pranjal-joshi/SMART/SMART_CPU/help_ss/betaConf.png

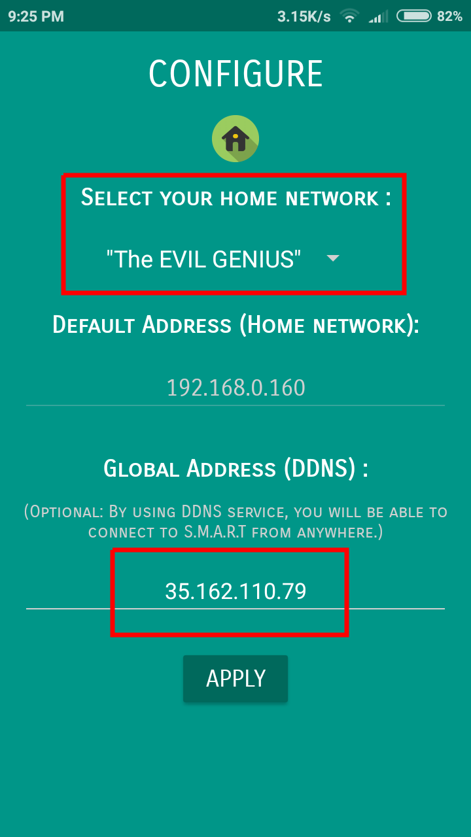
SMART_CPU/help_ss/betaConf.png
