pranjal-joshi/SMART/SMART_CPU/help_ss/config.jpg

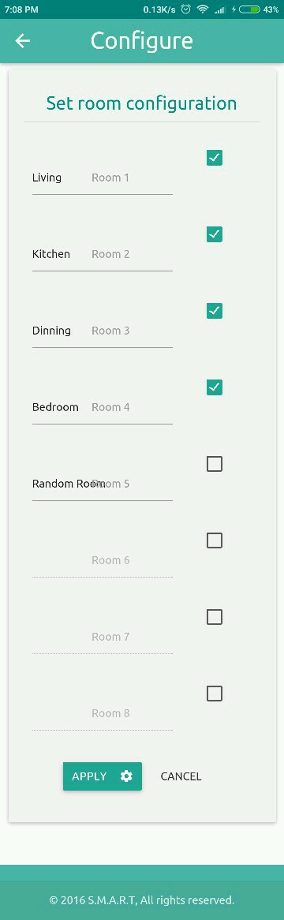
SMART_CPU/help_ss/config.jpg
