pranjal-joshi/SMART/SMART_CPU/help_ss/deviceRename.png

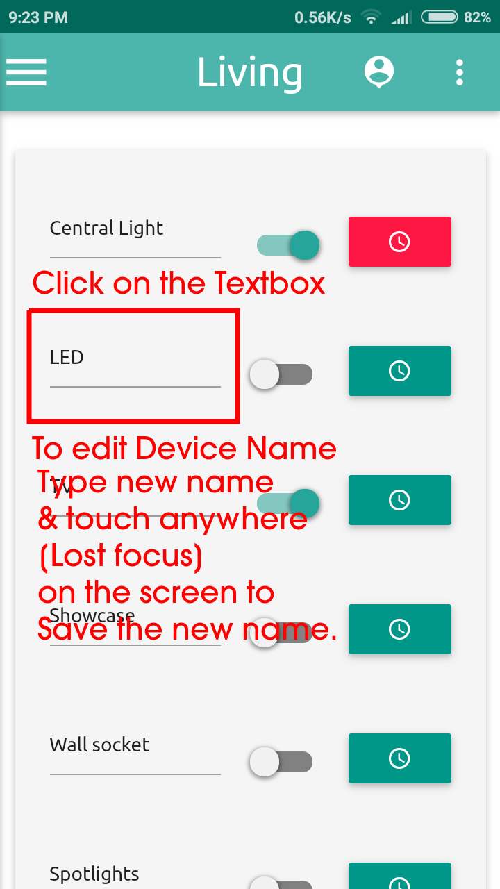
SMART_CPU/help_ss/deviceRename.png
