pranjal-joshi/SMART/SMART_CPU/help_ss/menu.jpg

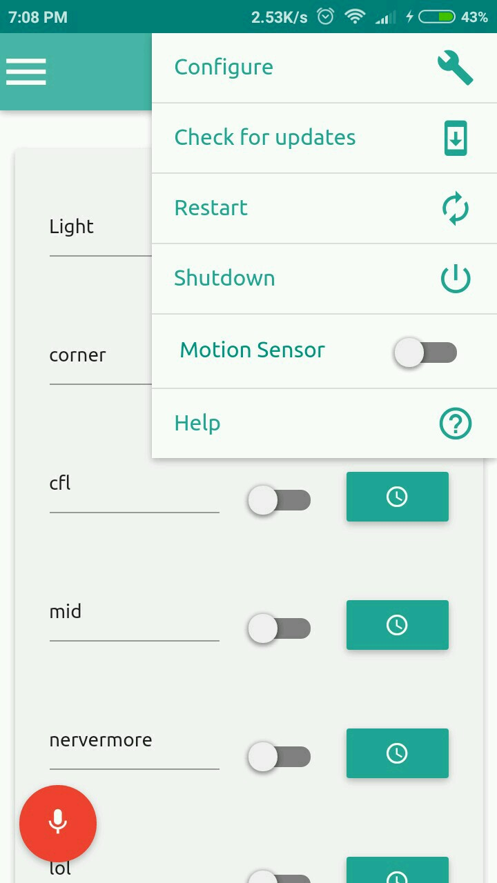
SMART_CPU/help_ss/menu.jpg
