pranjal-joshi/SMART/SMART_CPU/help_ss/profile.jpg

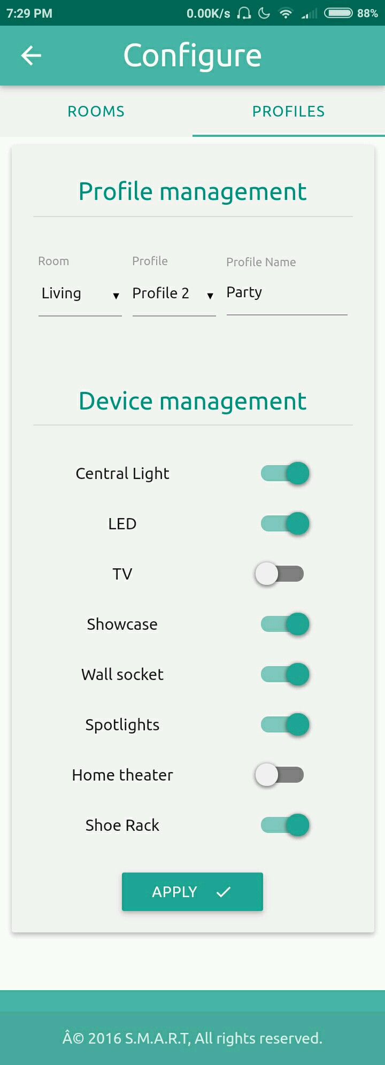
SMART_CPU/help_ss/profile.jpg
