pranjal-joshi/SMART/SMART_CPU/help_ss/Screenshot_2016-10-09-19-06-26-866_smart.webapp.jpg

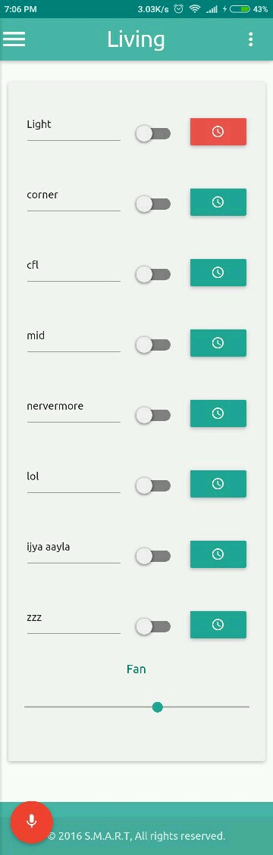
SMART_CPU/help_ss/Screenshot_2016-10-09-19-06-26-866_smart.webapp.jpg
