pranjal-joshi/SMART/SMART_CPU/help_ss/Screenshot_2016-10-09-19-11-12-575_smart.webapp.png

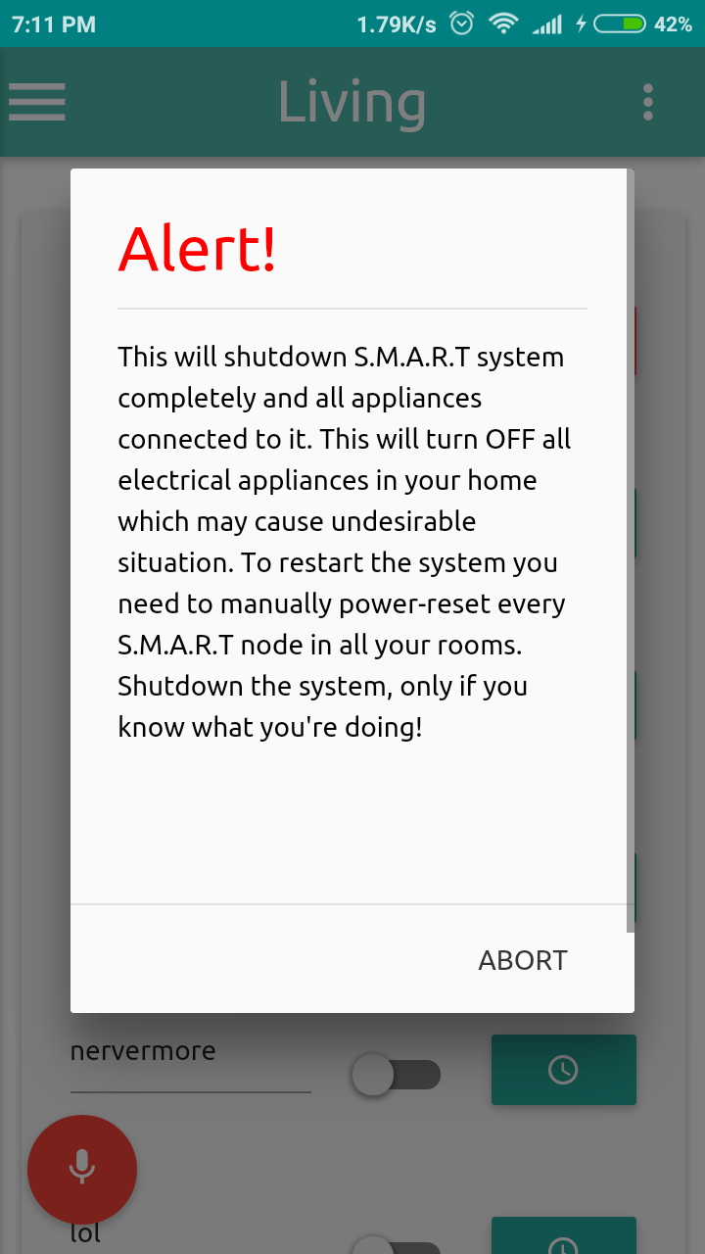
SMART_CPU/help_ss/Screenshot_2016-10-09-19-11-12-575_smart.webapp.png
