pranjal-joshi/SMART/SMART_CPU/help_ss/setProfile.png

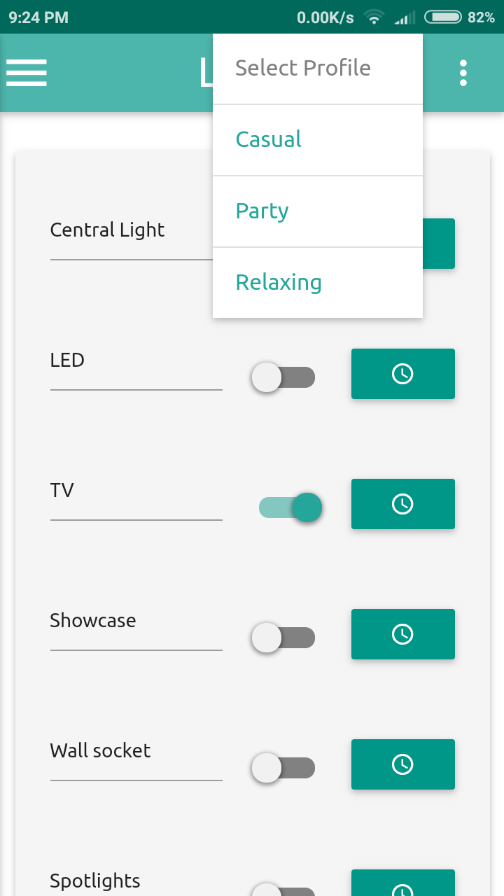
SMART_CPU/help_ss/setProfile.png
