pranjal-joshi/SMART/SMART_CPU/help_ss/timer.jpg

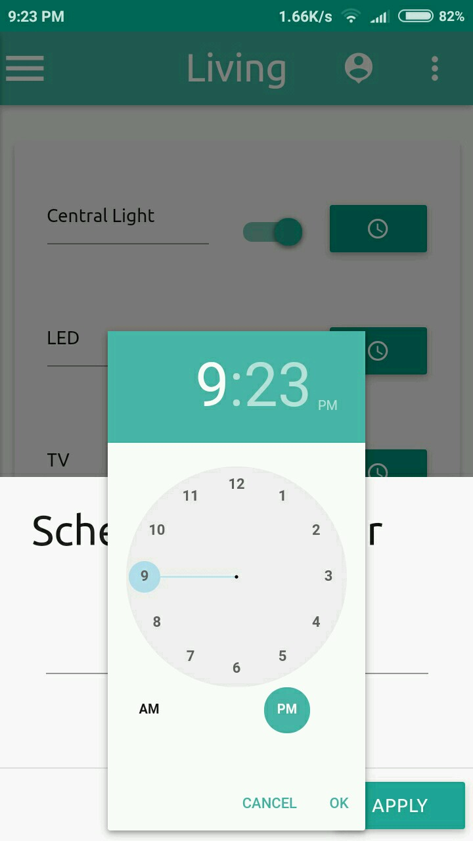
SMART_CPU/help_ss/timer.jpg
