pranjal-joshi/SMART/SMART_CPU/help_ss/update.png

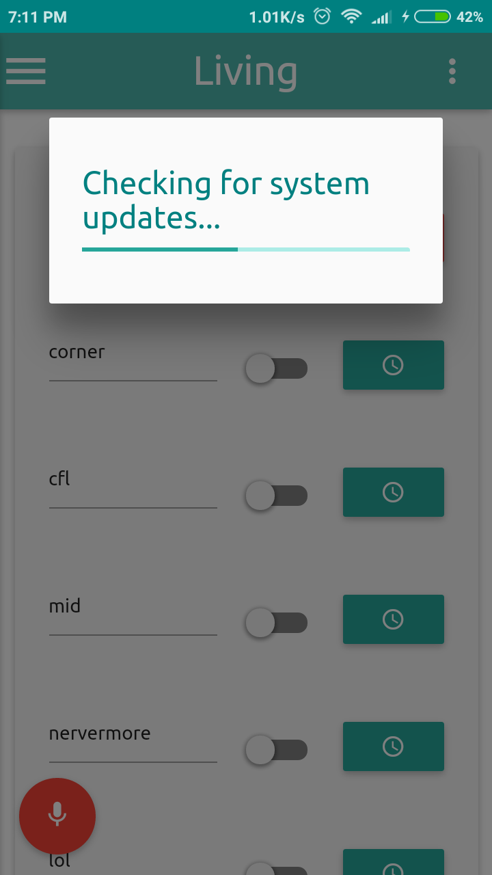
SMART_CPU/help_ss/update.png
