pranjal-joshi/SMART/v4_alexa_based/data/brand-removebg-preview.png

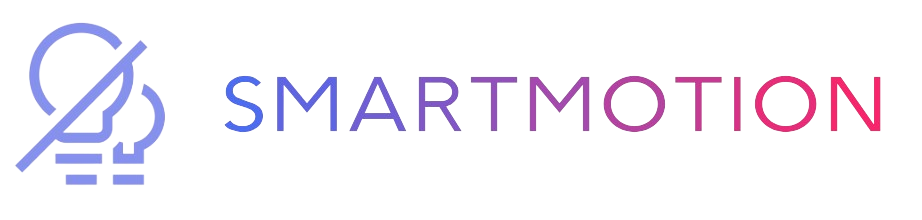
v4_alexa_based/data/brand-removebg-preview.png
