pranjal-joshi/SMART/v4_alexa_based/ESP01 vs ESP01-S.png

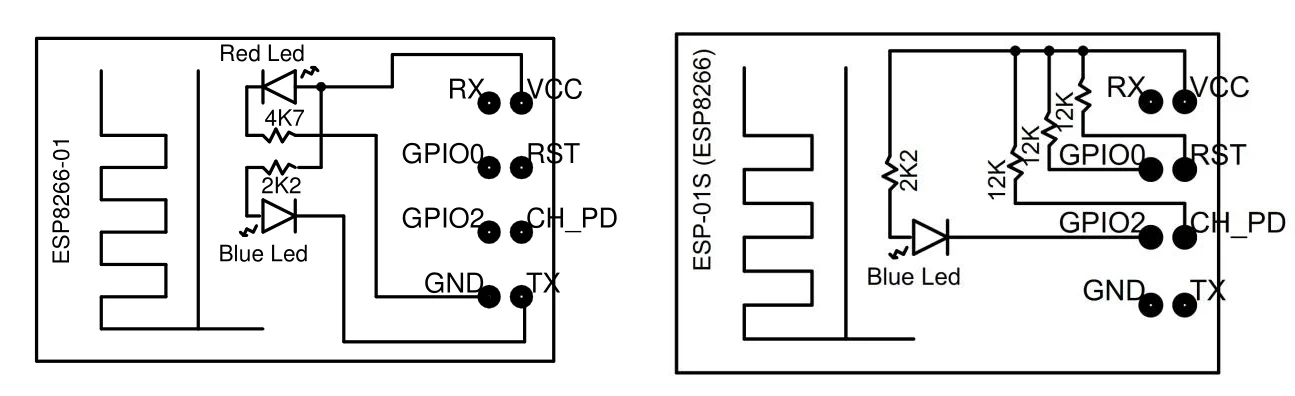
v4_alexa_based/ESP01 vs ESP01-S.png
