pranjal-joshi/SMART/v3/BOM.txt

# 5VDC Relay (230V-10A)
Make: Omron
MPN: G5Q-1-HA DC5
Mouser: https://www.mouser.in/ProductDetail/Omron-Electronics/G5Q-1-HA-DC5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
price: 89

# Relay driving transistor
Make: ON Semi
MPN: 2N3904TA
Mouser: https://www.mouser.in/ProductDetail/ON-Semiconductor-Fairchild/2N3904TA?qs=ljbEvF4DwOOn1Ev%2FzRYaoA%3D%3D
price: 11

# PCB mounted Fuse holder
Make: LittleFuse
MPN: 0PTF0078P
Mouser: https://www.mouser.in/ProductDetail/Littelfuse/0PTF0078P?qs=Co4VkB5J4%2Fsczy6gG8s%2FsA%3D%3D
price: 27

# 5mm screw terminal - 3 position
Make: Amphenol Anytek
MPN: 20020110-G031A01LF
Mouser: https://www.mouser.in/ProductDetail/Amphenol-Anytek/20020110-G031A01LF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
price: 20
