pranjal-joshi/SMART/v3/BOM_Final.xlsx

Sheet: v3 BOM
SMART v3 PCB - BOM
Qty | Value | Device | Package | Parts | Description | Manufacturer | Mfr. Part No. (MPN)
1 | NodeMCU | 113990105 | DIP2286W64P254L4826H735Q30N | NODEMCU | NodeMCU DEVKIT V1.0 (Please refer note-1) | Seeed Studio | 113990105
4 | Screw Terminal | CONN_03-SCREW-5MM | SCREWTERMINAL-5MM-3 | OUT_1, OUT_2, OUT_3, OUT_4 | 3 Terminal screw connector block with pitch size = 5mm
1 | 0PTF0078P | 0PTF0078P | 0PTF0078P | U2 | FUSEHOLDER-OPEN 5X20MM UL94V0 PITCH 22/6 | LITTELFUSE | 0PTF0078P
5 | 10K | 10K OHM-0603-1/10W-1% | 603 | R6, R9, R12, R15, R16 | 10k resistor - pkg 0603
8 | 15K_1/2W | R-US_R1210 | R1210 | R4, R5, R7, R8, R10, R11, R13, R14 | 15K resistor - 1/2 watt - pkg 1210
4 | 1N4002-E3_54 | 1N4002-E3_54 | DIOAD1405W86L465D235 | D1, D2, D3, D4 | VISHAY - 1N4002-E3/54 - STANDARD DIODE, 1A, 100V, DO-204AL | Vishay | 1N4002-E3/54
4 | 1k | 1KOHM-0603-1/10W-1% | 603 | R1, R2, R3, R20 | 1K resistor - pkg 0603
4 | 1uF | C-USC0805 | C0805 | C2, C3, C4, C5 | CAPACITOR, American symbol
2 | 2.54mm | CONN_03 | 1X03 | DC_OUT_1, DC_OUT_2 | Male berg strip connector - pitch 2.54mm
1 | 220V | CONN_025MM | SCREWTERMINAL-5MM-2 | AC_IN | 2 Terminal screw connector block with pitch size = 5mm
4 | 2N3904TA | 2N3904TA | BC33740TA | Q1, Q2, Q3, Q4 | Transistor GP BJT NPN 40V 0.2A TO92-3 | ON Semiconductor | 2N3904TA
1 | 470uF | 1000UF-RADIAL-5MM-35V-20%-KIT | CPOL-RADIAL-5MM-10MM-KIT | C1 | 470uF electrolytic capacitor
4 | G5Q-1-HA_DC5 | G5Q-1-HA_DC5 | G5Q1EU12DC | K1, K2, K3, K4 | Omron G5Q-1-HA DC5 relay (Use G5Q-1 DC5 if HA varaint is not available) | Omron Electronics | G5Q-1-HA DC5
1 | HLK-5M05 | HLK-5M05 | HLK5M05 | PS1 | 5W ultra-compact power module HLK-5M05 | Hi-Link | HLK-5M05
1 | MC74HC595ADG | MC74HC595ADG | SOIC127P600X175-16N | IC1 | Shift Register 8-Bit Latch 3State SOIC16 ON Semiconductor MC74HC595ADG, 8-stage, Shift Register, Serial to Serial/Parallel, 2 6 V, 16-Pin SOIC | ON Semiconductor | MC74HC595ADG
4 | SFH6206-3 | SFH6206-3 | SOP254P1005X410-4N | Q5, Q6, Q7, Q8 | SMD-4 CPLR 100-320% CTR -e3 | Vishay | SFH6206-3
PCB Dimensions |  | 134.32 mm (L) x 53.18 (W)
SMD |  | 26
Through-Hole |  | 24
Note-1: Instead of directly mounting the NodeMCU board, Please mount it on female berg strip connectors for easy detachment.

Sheet: Additional
DON’T USE THIS | 1 | G2RL-1-DC5 | Use Footptint of G2RL-1-HA-DC5 from mouser | 196 Rs | 240VAC, 12A, SPDT Relay | Omron | https://www.mouser.in/ProductDetail/Omron-Electronics/G2RL-1-DC5?qs=4BYd6zd2T8X2bNuRSnGw5A%3D%3D
 | 2 | G2RL-1-E-DC5 | Use Footptint of G2RL-1-E-DC12 from mouser | 230 Rs | 240VAC, 16A, SPDT Relay | Omron | https://www.mouser.in/ProductDetail/Omron-Electronics/G2RL-1-E-DC5
