pranjal-joshi/SMART/v3/BOM.xlsx

Bill Of materials - SMART_v3
Sr. No. | Description | Make | MPN | Price (10U) | Mouser Link
1 | 5VDC Relay | Omron | G5Q-1-HA DC5 | ₹89 | https://www.mouser.in/ProductDetail/Omron-Electronics/G5Q-1-HA-DC5
2 | Relay Driving transistor | On Semi | 2N3904TA | ₹11 | https://www.mouser.in/ProductDetail/ON-Semiconductor-Fairchild/2N3904TA?qs=ljbEvF4DwOOn1Ev%2FzRYaoA%3D%3D
3 | PCB mounted Fuse holder | LittleFuse | 0PTF0078P | ₹27 | https://www.mouser.in/ProductDetail/Littelfuse/0PTF0078P?qs=Co4VkB5J4%2Fsczy6gG8s%2FsA%3D%3D
4 | 5mm screw terminal - 3 position | Amphenol Anytek | TC0303620000G | ₹22 | https://www.mouser.in/ProductDetail/Amphenol-Anytek/TC0303620000G?qs=Mv7BduZupUgRMrlfdnWHCQ%3D%3D
5 | Bidirectional optocoupler (AC sensing) | Vishay | SFH6206-3 | ₹54 | https://www.mouser.in/ProductDetail/Vishay-Semiconductors/SFH6206-3?qs=xCMk%252BIHWTZOXG0TH%2FwrzoQ%3D%3D
6 | Opto input SMD resistor (1/2W) | Vishay | RCA121015K0FKEA | ₹8.2 | https://www.mouser.in/ProductDetail/Vishay-Draloric/RCA121015K0FKEA
7 | Freewheeling diode | Vishay | 1N4002-E3/54 | ₹12 | https://www.mouser.in/ProductDetail/Vishay-Semiconductors/1N4002-E3-54?qs=N4vtoAxH%2FSqs13dJhGS5gw%3D%3D
8 | Output Shift Reg | On Semi | MC74HC595ADG | ₹28 | https://www.mouser.in/ProductDetail/ON-Semiconductor/MC74HC595ADG?qs=qg33o%252B8vzFqEn75WJUGD8w%3D%3D
