pranjal-joshi/SMART/v3/PCB/CAMOutputs/Assembly/v3.csv

Qty | Value | Device | Package | Parts | Description | ARROW_PART_NUMBER | ARROW_PRICE-STOCK | DESCRIPTION | HEIGHT | MANUFACTURER_NAME | MANUFACTURER_PART_NUMBER | MOUSER_PART_NUMBER | MOUSER_PRICE-STOCK | POPULARITY | PROD_ID | SF_SKU | SPICEPREFIX | VALUE
1 |  | 113990105 | DIP2286W64P254L4826H735Q30N | NODEMCU | NodeMCU DEVKIT V1.0 | 113990105 | https://www.arrow.com/en/products/113990105/seeed-technology-limited | NodeMCU DEVKIT V1.0 | 7.35mm | Seeed Studio | 113990105 | 713-113990105 | https://www.mouser.co.uk/ProductDetail/Seeed-Studio/113990105?qs=SElPoaY2y5KMx8k1roAIKw%3D%3D
4 |  | CONN_03-SCREW-5MM | SCREWTERMINAL-5MM-3 | OUT_1, OUT_2, OUT_3, OUT_4 | Multi connection point. Often used as Generic Header-pin footprint for 0.1 inch spaced/style header connections |  |  |  |  |  |  |  |  |  | CONN-10134 | PRT-08433
1 | 0PTF0078P | 0PTF0078P | 0PTF0078P | U2 | FUSEHOLDER-OPEN 5X20MM UL94V0 PITCH 22/6 |  |  | FUSEHOLDER-OPEN 5X20MM UL94V0 PITCH 22/6 | 11.5mm | LITTELFUSE | 0PTF0078P | 576-0PTF0078P | https://www.mouser.co.uk/ProductDetail/Littelfuse/0PTF0078P?qs=Co4VkB5J4%2Fsczy6gG8s%2FsA%3D%3D
5 | 10K | 1KOHM-0603-1/10W-1% | 0603 | R6, R9, R12, R15, R16 | 1kΩ resistor |  |  |  |  |  |  |  |  |  | RES-07856 |  |  | 1k
8 | 15K_1/2W | R-US_R1210 | R1210 | R4, R5, R7, R8, R10, R11, R13, R14 | RESISTOR, American symbol |  |  |  |  |  |  |  |  | 0 |  |  | R
4 | 1N4002-E3_54 | 1N4002-E3_54 | DIOAD1405W86L465D235 | D1, D2, D3, D4 | VISHAY - 1N4002-E3/54 - STANDARD DIODE, 1A, 100V, DO-204AL, FULL REEL |  |  | VISHAY - 1N4002-E3/54 - STANDARD DIODE, 1A, 100V, DO-204AL, FULL REEL | mm | Vishay | 1N4002-E3/54 | 625-1N4002-E3/54 | https://www.mouser.co.uk/ProductDetail/Vishay-Semiconductors/1N4002-E3-54?qs=N4vtoAxH%2FSqs13dJhGS5gw%3D%3D
4 | 1k | 1KOHM-0603-1/10W-1% | 0603 | R1, R2, R3, R20 | 1kΩ resistor |  |  |  |  |  |  |  |  |  | RES-07856 |  |  | 1k
4 | 1uF | C-USC0805 | C0805 | C2, C3, C4, C5 | CAPACITOR, American symbol |  |  |  |  |  |  |  |  | 63 |  |  | C
2 | 2.54mm | CONN_03 | 1X03 | DC_OUT_1, DC_OUT_2 | Multi connection point. Often used as Generic Header-pin footprint for 0.1 inch spaced/style header connections |  |  |  |  |  |  |  |  |  | XXX-00000 |  |  | 455-1750-1-ND
1 | 220V | CONN_025MM | SCREWTERMINAL-5MM-2 | AC_IN | Multi connection point. Often used as Generic Header-pin footprint for 0.1 inch spaced/style header connections |  |  |  |  |  |  |  |  |  |  | PRT-08432
4 | 2N3904TA | 2N3904TA | BC33740TA | Q1, Q2, Q3, Q4 | Transistor GP BJT NPN 40V 0.2A TO92-3 |  |  | Transistor GP BJT NPN 40V 0.2A TO92-3 | mm | ON Semiconductor | 2N3904TA | 512-2N3904TA | https://www.mouser.co.uk/ProductDetail/ON-Semiconductor-Fairchild/2N3904TA?qs=ljbEvF4DwOOn1Ev%2FzRYaoA%3D%3D
1 | 470uF | 1000UF-RADIAL-5MM-35V-20%-KIT | CPOL-RADIAL-5MM-10MM-KIT | C1 | 1,000µF/1mF ceramic capacitors |  |  |  |  |  |  |  |  |  | CAP-09538 |  |  | 1mf
4 | G5Q-1-HA_DC5 | G5Q-1-HA_DC5 | G5Q1EU12DC | K1, K2, K3, K4 | General Purpose Relays PCB Power Relay Mini 1-pole 10A |  |  | General Purpose Relays PCB Power Relay Mini 1-pole 10A | 15.8mm | Omron Electronics | G5Q-1-HA DC5 | 653-G5Q-1-HADC5 | https://www.mouser.co.uk/ProductDetail/Omron-Electronics/G5Q-1-HA-DC5?qs=xZ%2FP%252Ba9zWqZWP6NLX9Nrlg%3D%3D
1 | HLK-5M05 | HLK-5M05 | HLK5M05 | PS1 | 5W ultra-compact power module HLK-5M05 | HLK-5M05 |  | 5W ultra-compact power module HLK-5M05 | 18mm | Hi-Link | HLK-5M05
1 | MC74HC595ADG | MC74HC595ADG | SOIC127P600X175-16N | IC1 | Shift Register 8-Bit Latch 3State SOIC16 ON Semiconductor MC74HC595ADG, 8-stage, Shift Register, Serial to Serial/Parallel, 2 6 V, 16-Pin SOIC |  |  | Shift Register 8-Bit Latch 3State SOIC16 ON Semiconductor MC74HC595ADG, 8-stage, Shift Register, Serial to Serial/Parallel, 2 6 V, 16-Pin SOIC | 1.75mm | ON Semiconductor | MC74HC595ADG | 863-MC74HC595ADG | https://www.mouser.co.uk/ProductDetail/ON-Semiconductor/MC74HC595ADG?qs=qg33o%252B8vzFqEn75WJUGD8w%3D%3D
3 | MOUNT-HOLE3.3 | MOUNT-HOLE3.3 | 3,3 | H1, H3, H4 | MOUNTING HOLE with drill center marker
4 | SFH6206-3 | SFH6206-3 | SOP254P1005X410-4N | Q5, Q6, Q7, Q8 | SMD-4 CPLR 100-320% CTR -e3 |  |  | SMD-4 CPLR 100-320% CTR -e3 | 4.1mm | Vishay | SFH6206-3 | 782-SFH6206-3 | https://www.mouser.com/Search/Refine.aspx?Keyword=782-SFH6206-3
