pranjal-joshi/SMART/v3/PCB/v3_NoD2_schematic.pdf

A

B

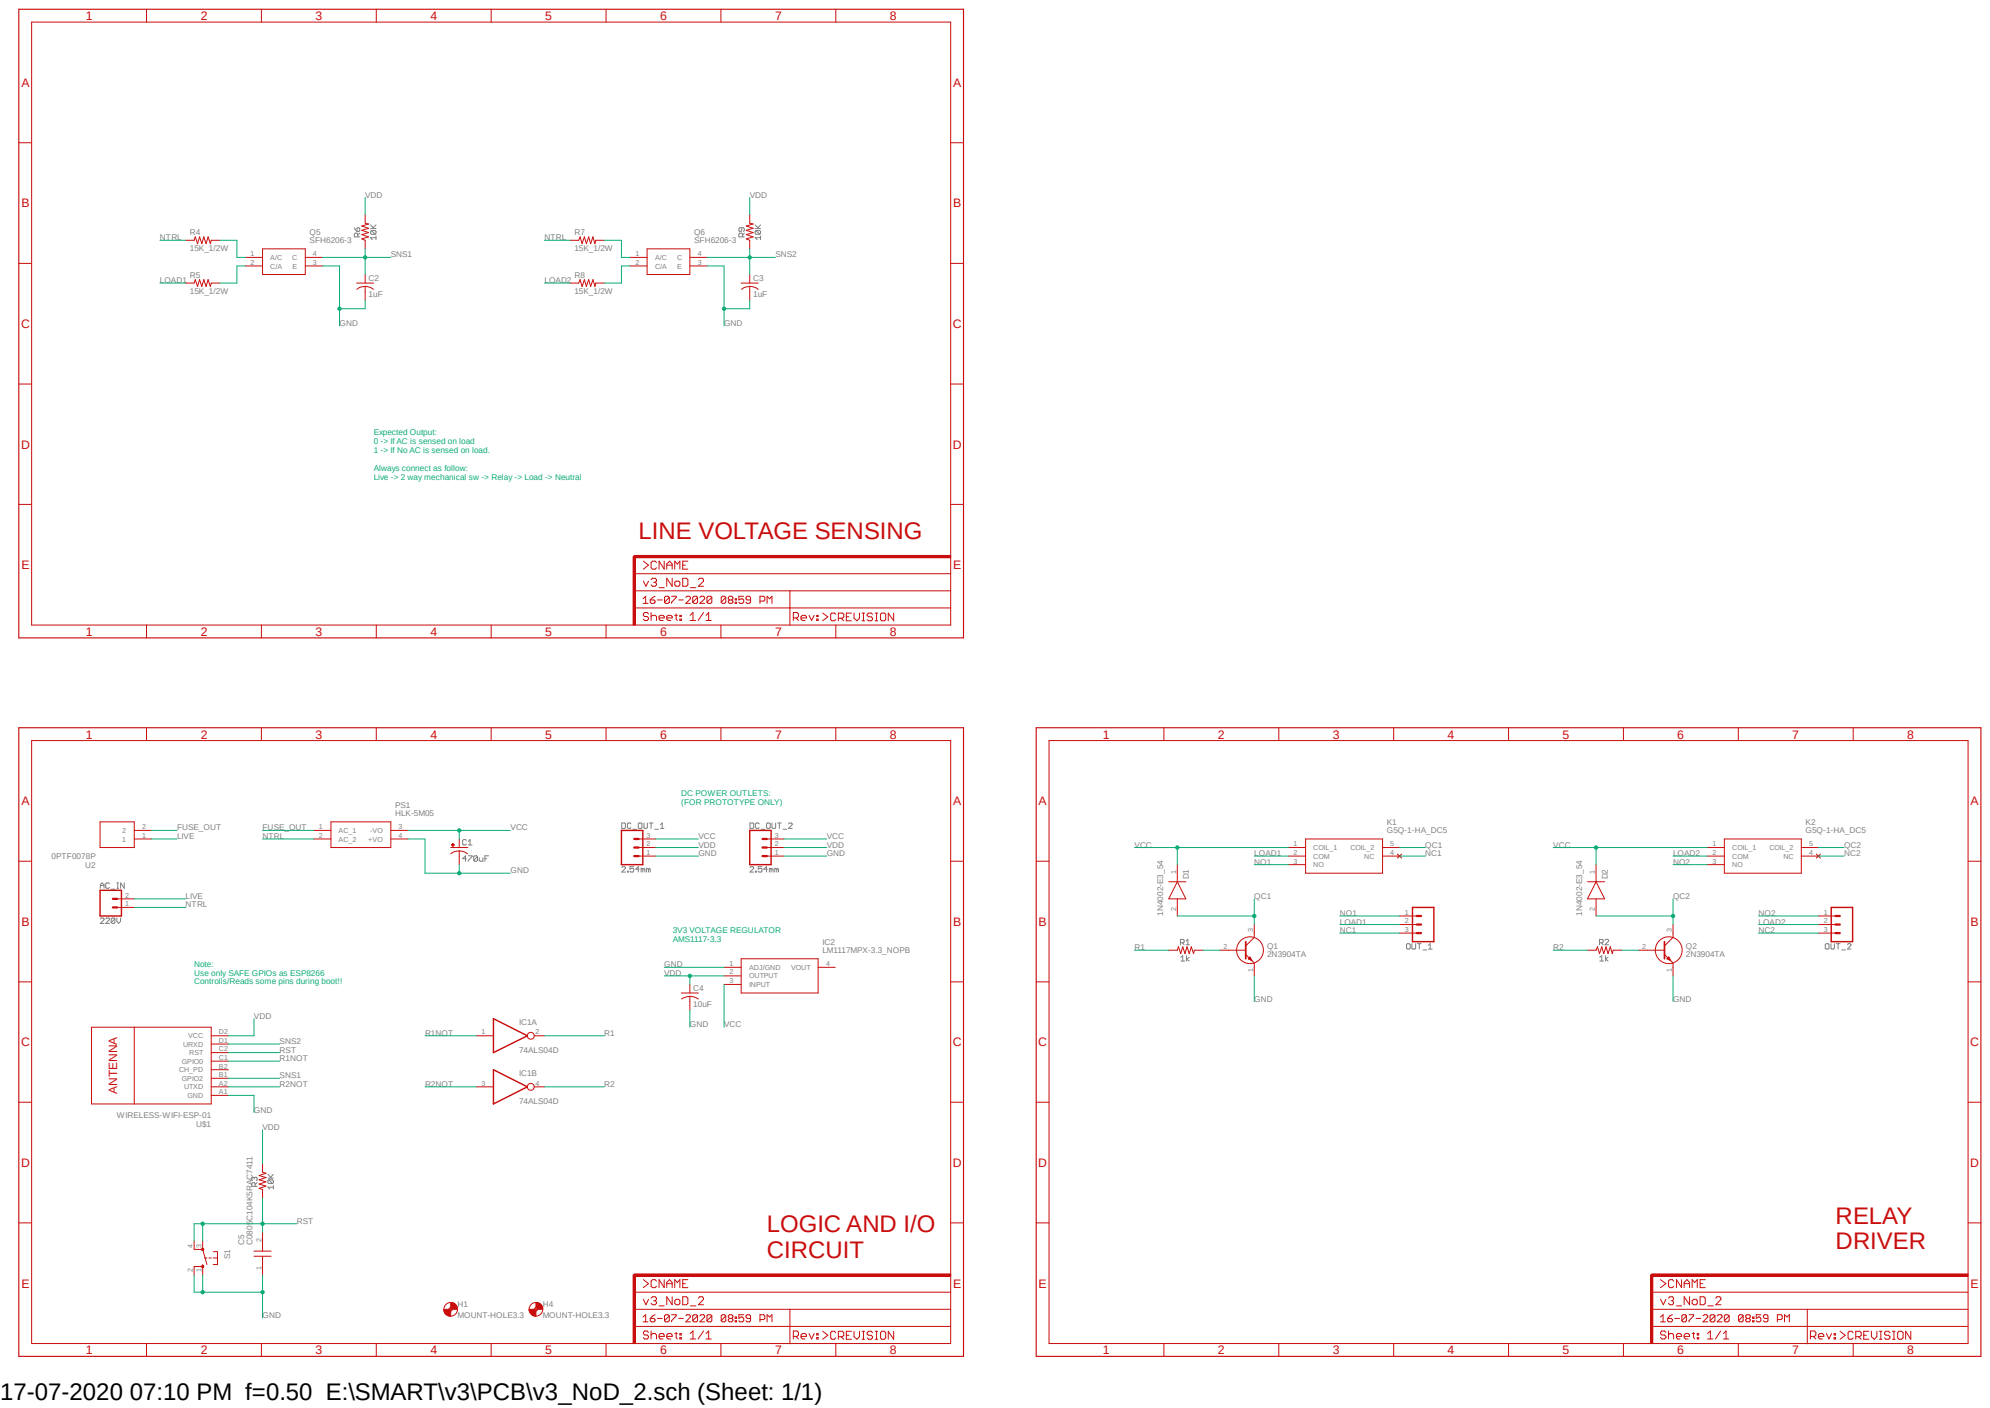
[picture p14: page 1]

Expected Output:
0 -> If AC is sensed on load
1 -> If No AC is sensed on load.
Always connect as follow:
Live -> 2 way mechanical sw -> Relay -> Load -> Neutral

Note:
Use only SAFE GPIOs as ESP8266
Controlls/Reads some pins during boot!!

17-07-2020 07:10 PM f=0.50 E:\SMART\v3\PCB\v3_NoD_2.sch (Sheet: 1/1)
