pranjal-joshi/SMART/v3/PCB/v3.brd

## EAGLE design v3/PCB/v3.brd (2020-06-10)

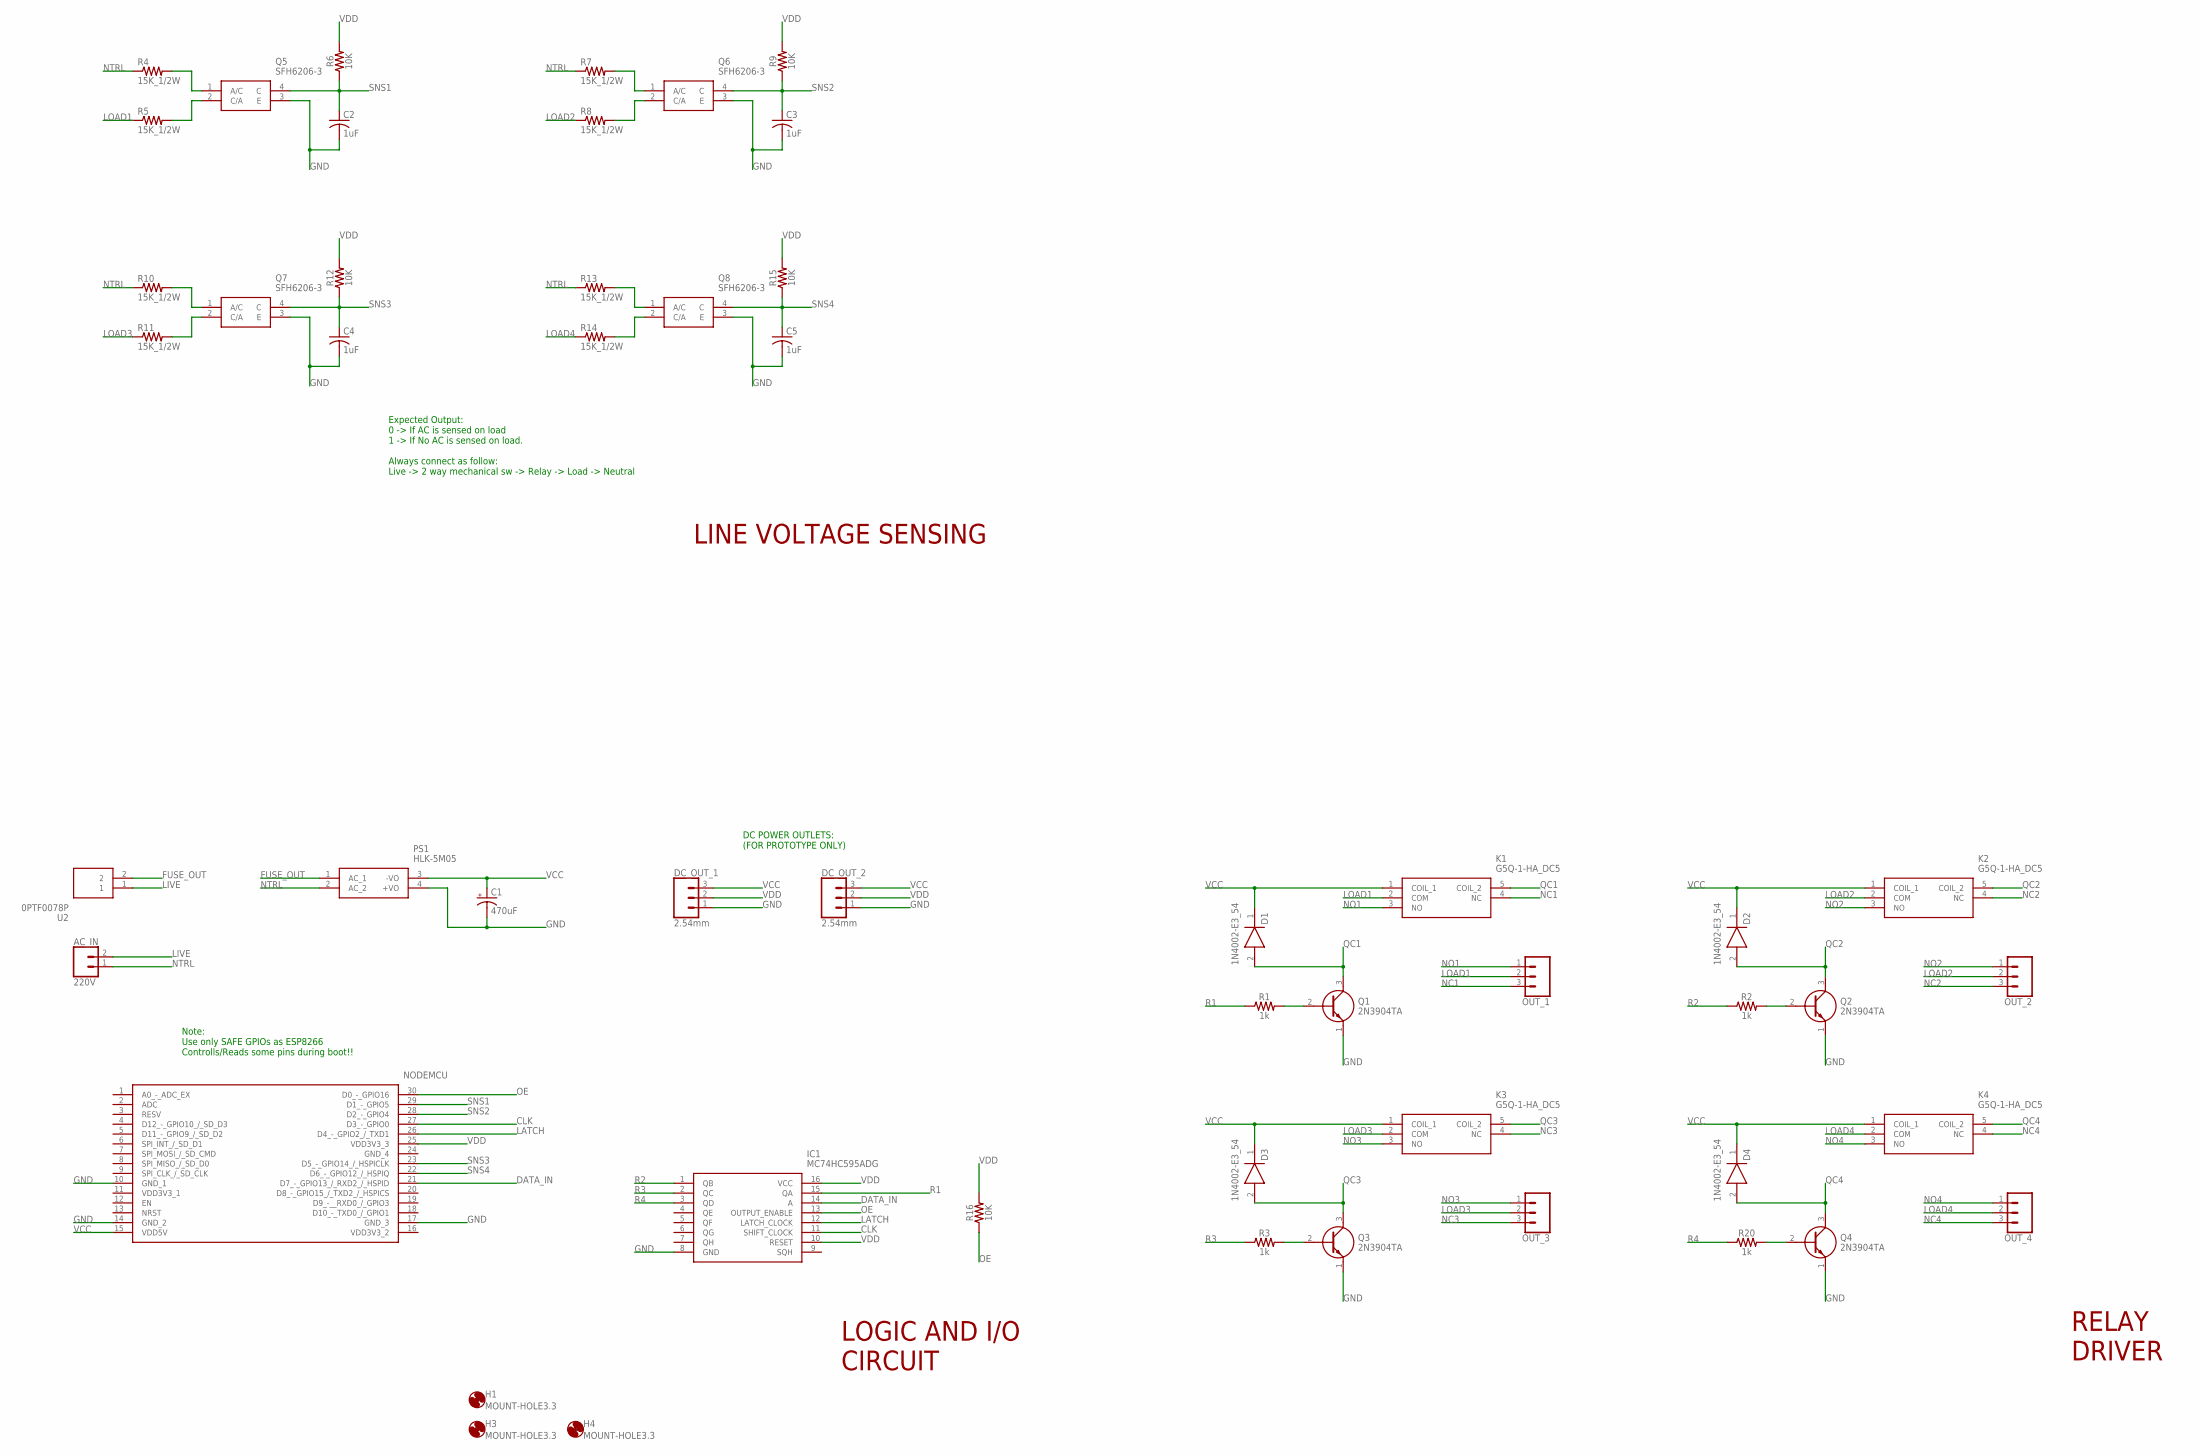
[picture p15: schematic v3.sch]

Parts:
AC_IN: 220V; SCREWTERMINAL-5MM-2
C1: 470uF; CPOL-RADIAL-5MM-10MM-KIT
C2, C3, C4, C5: 1uF; C0805
D1, D2, D3, D4: 1N4002-E3_54; DIOAD1405W86L465D235
DC_OUT_1, DC_OUT_2: 2.54mm; 1X03
H1, H3, H4: MOUNT-HOLE3.3; 3,3
IC1: MC74HC595ADG; SOIC127P600X175-16N
K1, K2, K3, K4: G5Q-1-HA_DC5; G5Q1EU12DC
NODEMCU: 113990105; DIP2286W64P254L4826H735Q30N
OUT_1, OUT_2, OUT_3, OUT_4: CONN_03-SCREW-5MM; SCREWTERMINAL-5MM-3
PS1: HLK-5M05; HLK5M05
Q1, Q2, Q3, Q4: 2N3904TA; BC33740TA
Q5, Q6, Q7, Q8: SFH6206-3; SOP254P1005X410-4N
R1, R2, R3, R20: 1k; 0603
R4, R5, R7, R8, R10, R11, R13, R14: 15K_1/2W; R1210
R6, R9, R12, R15, R16: 10K; 0603
U2: 0PTF0078P

Connections:
CLK: IC1.11 (SHIFT_CLOCK), NODEMCU.27 (D3_-_GPIO0)
DATA_IN: IC1.14 (A), NODEMCU.21 (D7_-_GPIO13_/_RXD2_/_HSPID)
FUSE_OUT: PS1.1 (AC_1), U2.2
GND: C1.-, C2.2, C3.2, C4.2, C5.2, DC_OUT_1.1, DC_OUT_2.1, IC1.8 (GND), NODEMCU.10 (GND_1), NODEMCU.14 (GND_2), NODEMCU.17 (GND_3), PS1.4 (+VO), Q1.1 (E), Q2.1 (E), Q3.1 (E), Q4.1 (E), Q5.3 (E), Q6.3 (E), Q7.3 (E), Q8.3 (E)
GND_4: NODEMCU.24 (GND_4)
LATCH: IC1.12 (LATCH_CLOCK), NODEMCU.26 (D4_-_GPIO2_/_TXD1)
LIVE: AC_IN.2, U2.1
LOAD1: K1.2 (COM), OUT_1.2, R5.1
LOAD2: K2.2 (COM), OUT_2.2, R8.1
LOAD3: K3.2 (COM), OUT_3.2, R11.1
LOAD4: K4.2 (COM), OUT_4.2, R14.1
unnamed: Q5.1 (A/C), R4.2
unnamed: Q5.2 (C/A), R5.2
unnamed: Q6.1 (A/C), R7.2
unnamed: Q1.2 (B), R1.2
unnamed: Q2.2 (B), R2.2
unnamed: Q6.2 (C/A), R8.2
unnamed: Q7.1 (A/C), R10.2
unnamed: Q7.2 (C/A), R11.2
unnamed: Q8.1 (A/C), R13.2
unnamed: Q8.2 (C/A), R14.2
unnamed: Q3.2 (B), R3.2
unnamed: Q4.2 (B), R20.2
NC1: K1.4 (NC), OUT_1.3
NC2: K2.4 (NC), OUT_2.3
NC3: K3.4 (NC), OUT_3.3
NC4: K4.4 (NC), OUT_4.3
NO1: K1.3 (NO), OUT_1.1
NO2: K2.3 (NO), OUT_2.1
NO3: K3.3 (NO), OUT_3.1
NO4: K4.3 (NO), OUT_4.1
NTRL: AC_IN.1, PS1.2 (AC_2), R4.1, R7.1, R10.1, R13.1
OE: IC1.13 (OUTPUT_ENABLE), NODEMCU.30 (D0_-_GPIO16), R16.1
QC1: D1.2 (A), K1.5 (COIL_2), Q1.3 (C)
QC2: D2.2 (A), K2.5 (COIL_2), Q2.3 (C)
QC3: D3.2 (A), K3.5 (COIL_2), Q3.3 (C)
QC4: D4.2 (A), K4.5 (COIL_2), Q4.3 (C)
R1: IC1.15 (QA), R1.1
R2: IC1.1 (QB), R2.1
R3: IC1.2 (QC), R3.1
R4: IC1.3 (QD), R20.1
SNS1: C2.1, NODEMCU.29 (D1_-_GPIO5), Q5.4 (C), R6.1
SNS2: C3.1, NODEMCU.28 (D2_-_GPIO4), Q6.4 (C), R9.1
SNS3: C4.1, NODEMCU.23 (D5_-_GPIO14_/_HSPICLK), Q7.4 (C), R12.1
SNS4: C5.1, NODEMCU.22 (D6_-_GPIO12_/_HSPIQ), Q8.4 (C), R15.1
VCC: C1.+, D1.1 (K), D2.1 (K), D3.1 (K), D4.1 (K), DC_OUT_1.3, DC_OUT_2.3, K1.1 (COIL_1), K2.1 (COIL_1), K3.1 (COIL_1), K4.1 (COIL_1), NODEMCU.15 (VDD5V), PS1.3 (-VO)
VDD: DC_OUT_1.2, DC_OUT_2.2, IC1.10 (RESET), IC1.16 (VCC), NODEMCU.25 (VDD3V3_3), R6.2, R9.2, R12.2, R15.2, R16.2
VDD3V3_1: NODEMCU.11 (VDD3V3_1)
VDD3V3_2: NODEMCU.16 (VDD3V3_2)

Notes on the sheet:
LOGIC AND I/O CIRCUIT
LINE VOLTAGE SENSING
RELAY DRIVER
DC POWER OUTLETS: (FOR PROTOTYPE ONLY)
Expected Output: 0 -> If AC is sensed on load 1 -> If No AC is sensed on load. Always connect as follow: Live -> 2 way mechanical sw -> Relay -> Load -> Neutral
Note: Use only SAFE GPIOs as ESP8266 Controlls/Reads some pins during boot!!

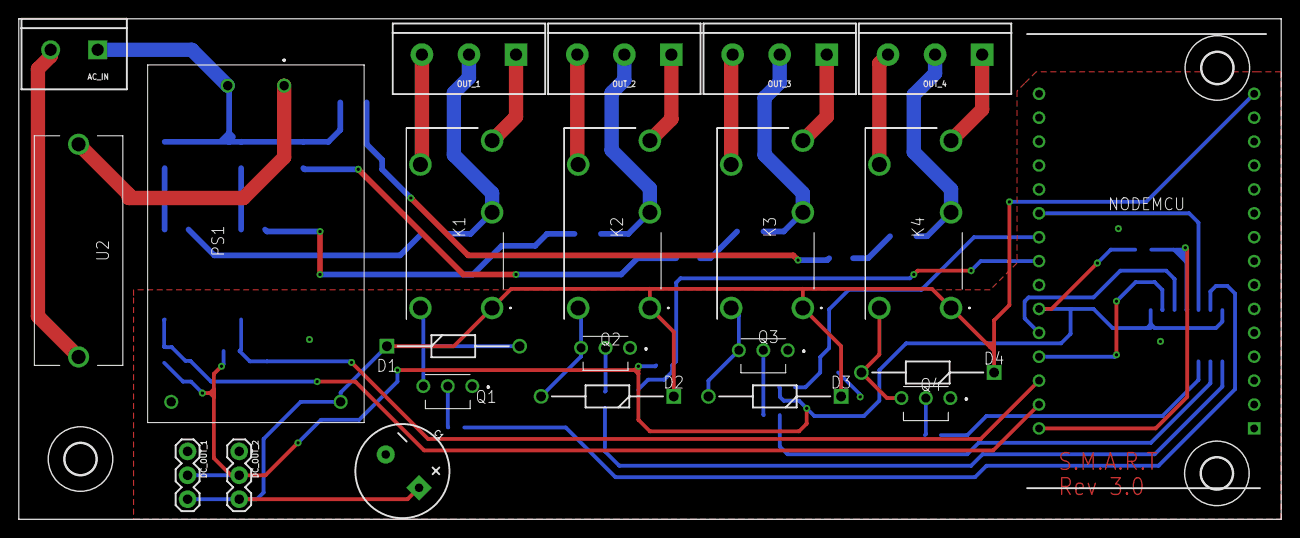
[picture p16: board v3.brd from above]

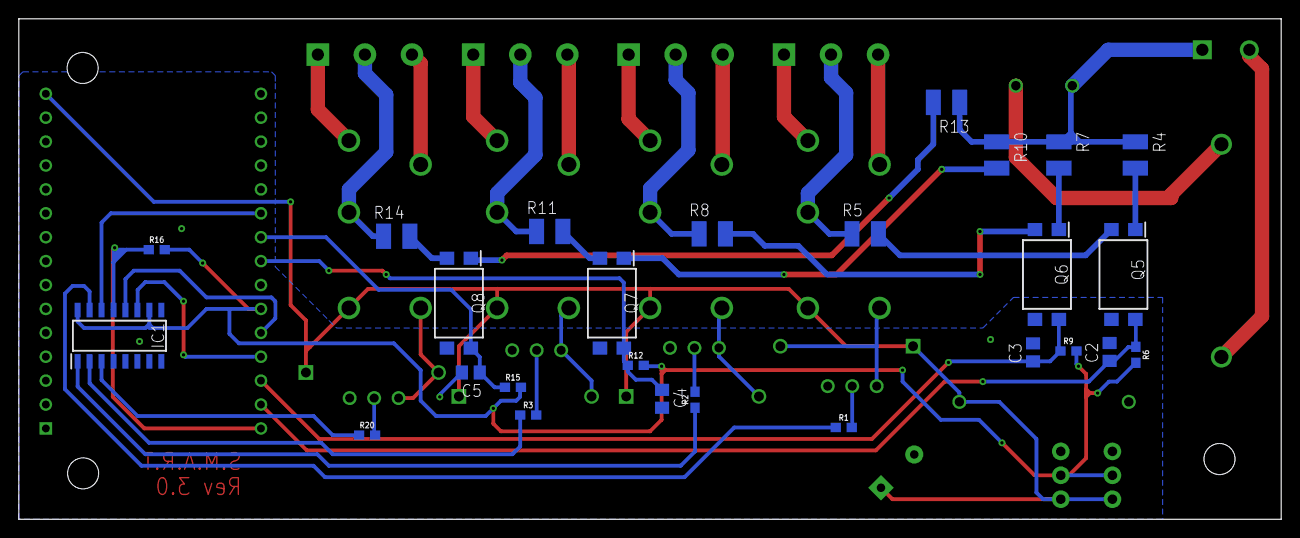
[picture p17: board v3.brd from below]

Board: 2 copper layers, 134.1 x 53.2 mm, 52 parts (26 on the bottom side), 46 nets.
