pranjal-joshi/SMART/v3/PCB/old_smart_nodemcu_reroute.brd

## EAGLE design v3/PCB/old_smart_nodemcu_reroute.brd (2020-06-07, an earlier design)

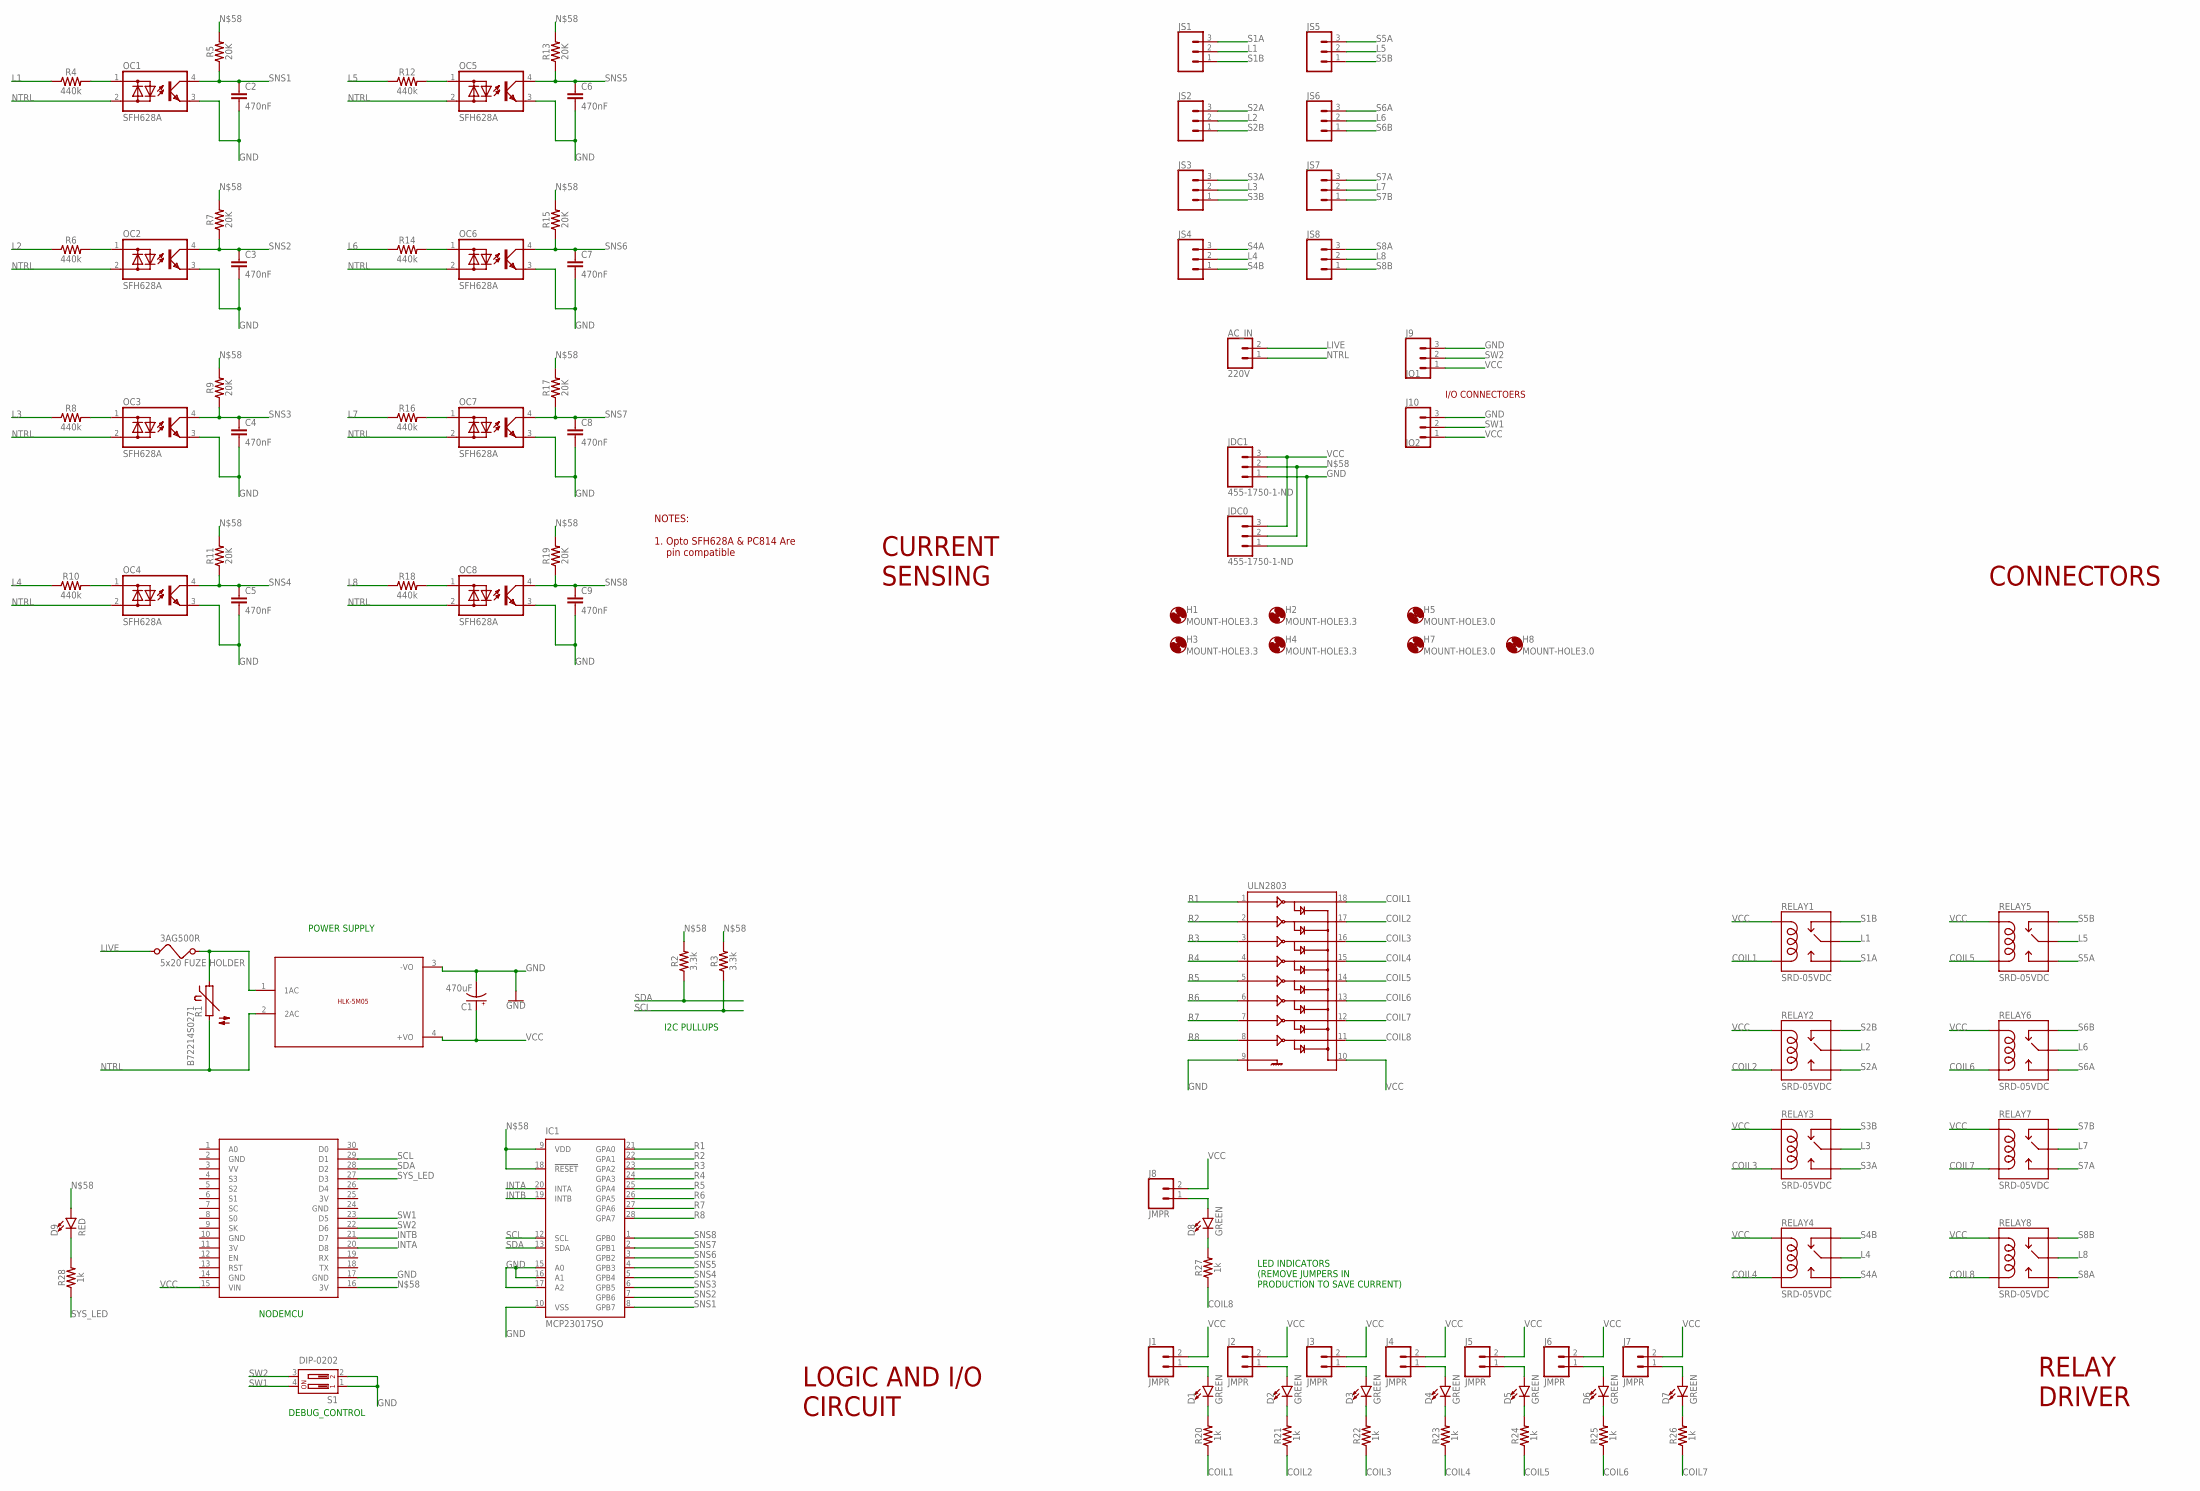
[picture p18: schematic old_smart_nodemcu_reroute.sch]

Parts:
3AG500R: 5x20 FUZE HOLDER; FUSE
AC_IN: 220V; SCREWTERMINAL-5MM-2
C1: 470uF; E3,5-8
C2, C3, C4, C5, C6, C7, C8, C9: 470nF; 0603
D1, D2, D3, D4, D5, D6, D7, D8: GREEN; LED-0603
D9: RED; LED-0603
H1, H2, H3, H4: MOUNT-HOLE3.3; 3,3
H5, H7, H8: MOUNT-HOLE3.0; 3,0
IC1: MCP23017SO; SO28W
J1, J2, J3, J4, J5, J6, J7, J8: JMPR; 1X02
J9: IO1; 1X03
J10: IO2; 1X03
JDC0, JDC1: 455-1750-1-ND; 1X03
JS1, JS2, JS3, JS4, JS5, JS6, JS7, JS8: CONN_03-SCREW-5MM; SCREWTERMINAL-5MM-3
NODEMCU: NODEMCU
OC1, OC2, OC3, OC4, OC5, OC6, OC7, OC8: SFH628A; DIL4-SMD
R1: B72214S0271; P592
R2, R3: 3.3k; 0603
R4, R6, R8, R10, R12, R14, R16, R18: 440k; 0805
R5, R7, R9, R11, R13, R15, R17, R19: 20K; 0603
R20, R21, R22, R23, R24, R25, R26, R27, R28: 1k; 0603
RELAY1, RELAY2, RELAY3, RELAY4, RELAY5, RELAY6, RELAY7, RELAY8: SRD-05VDC; SRD-05VDC-SL-C
S1: DIP-0202; DIPSWITCH-02
U$1: 5VDC/5W; HLK-5M05
ULN2803: ULN2803SOICW; SO18L

Connections:
3V: NODEMCU.11 (3V), NODEMCU.25 (3V)
COIL1: R20.1, RELAY1.COIL0, ULN2803.18
COIL2: R21.1, RELAY2.COIL0, ULN2803.17
COIL3: R22.1, RELAY3.COIL0, ULN2803.16
COIL4: R23.1, RELAY4.COIL0, ULN2803.15
COIL5: R24.1, RELAY5.COIL0, ULN2803.14
COIL6: R25.1, RELAY6.COIL0, ULN2803.13
COIL7: R26.1, RELAY7.COIL0, ULN2803.12
COIL8: R27.1, RELAY8.COIL0, ULN2803.11
GND: C1.-, C2.2, C3.2, C4.2, C5.2, C6.2, C7.2, C8.2, C9.2, IC1.10 (VSS), IC1.15 (A0), IC1.16 (A1), IC1.17 (A2), J9.3, J10.3, JDC0.1, JDC1.1, NODEMCU.2 (GND), NODEMCU.10 (GND), NODEMCU.14 (GND), NODEMCU.17 (GND), NODEMCU.24 (GND), OC1.3 (E), OC2.3 (E), OC3.3 (E), OC4.3 (E), OC5.3 (E), OC6.3 (E), OC7.3 (E), OC8.3 (E), S1.1, S1.2, U$1.3 (-VO), ULN2803.9
INTA: IC1.20 (INTA), NODEMCU.20 (D8)
INTB: IC1.19 (INTB), NODEMCU.21 (D7)
L1: JS1.2, R4.1, RELAY1.SWCOMMON
L2: JS2.2, R6.1, RELAY2.SWCOMMON
L3: JS3.2, R8.1, RELAY3.SWCOMMON
L4: JS4.2, R10.1, RELAY4.SWCOMMON
L5: JS5.2, R12.1, RELAY5.SWCOMMON
L6: JS6.2, R14.1, RELAY6.SWCOMMON
L7: JS7.2, R16.1, RELAY7.SWCOMMON
L8: JS8.2, R18.1, RELAY8.SWCOMMON
LIVE: 3AG500R.1, AC_IN.2
LIVE_FUSE: 3AG500R.2, R1.1, U$1.1 (1AC)
unnamed: OC1.1 (AC1), R4.2
unnamed: OC2.1 (AC1), R6.2
unnamed: OC3.1 (AC1), R8.2
unnamed: D1.A, J1.1
unnamed: OC5.1 (AC1), R12.2
unnamed: OC6.1 (AC1), R14.2
unnamed: OC7.1 (AC1), R16.2
unnamed: OC4.1 (AC1), R10.2
unnamed: OC8.1 (AC1), R18.2
unnamed: D1.C, R20.2
unnamed: D2.A, J2.1
unnamed: D2.C, R21.2
unnamed: D3.A, J3.1
unnamed: D3.C, R22.2
unnamed: D4.A, J4.1
unnamed: D4.C, R23.2
unnamed: D5.A, J5.1
unnamed: D5.C, R24.2
unnamed: D6.A, J6.1
unnamed: D6.C, R25.2
unnamed: D7.A, J7.1
unnamed: D7.C, R26.2
unnamed: D8.A, J8.1
unnamed: D8.C, R27.2
unnamed: D9.C, R28.2
unnamed: D9.A, IC1.9 (VDD), IC1.18 (!RESET), JDC0.2, JDC1.2, NODEMCU.16 (3V), R2.2, R3.2, R5.2, R7.2, R9.2, R11.2, R13.2, R15.2, R17.2, R19.2
NTRL: AC_IN.1, OC1.2 (AC2), OC2.2 (AC2), OC3.2 (AC2), OC4.2 (AC2), OC5.2 (AC2), OC6.2 (AC2), OC7.2 (AC2), OC8.2 (AC2), R1.2, U$1.2 (2AC)
R1: IC1.21 (GPA0), ULN2803.1
R2: IC1.22 (GPA1), ULN2803.2
R3: IC1.23 (GPA2), ULN2803.3
R4: IC1.24 (GPA3), ULN2803.4
R5: IC1.25 (GPA4), ULN2803.5
R6: IC1.26 (GPA5), ULN2803.6
R7: IC1.27 (GPA6), ULN2803.7
R8: IC1.28 (GPA7), ULN2803.8
S1A: JS1.3, RELAY1.SWOPEN
S1B: JS1.1, RELAY1.SWCLOSED (SWCLOSE)
S2A: JS2.3, RELAY2.SWOPEN
S2B: JS2.1, RELAY2.SWCLOSED (SWCLOSE)
S3A: JS3.3, RELAY3.SWOPEN
S3B: JS3.1, RELAY3.SWCLOSED (SWCLOSE)
S4A: JS4.3, RELAY4.SWOPEN
S4B: JS4.1, RELAY4.SWCLOSED (SWCLOSE)
S5A: JS5.3, RELAY5.SWOPEN
S5B: JS5.1, RELAY5.SWCLOSED (SWCLOSE)
S6A: JS6.3, RELAY6.SWOPEN
S6B: JS6.1, RELAY6.SWCLOSED (SWCLOSE)
S7A: JS7.3, RELAY7.SWOPEN
S7B: JS7.1, RELAY7.SWCLOSED (SWCLOSE)
S8A: JS8.3, RELAY8.SWOPEN
S8B: JS8.1, RELAY8.SWCLOSED (SWCLOSE)
SCL: IC1.12 (SCL), NODEMCU.29 (D1), R3.1
SDA: IC1.13 (SDA), NODEMCU.28 (D2), R2.1
SNS1: C2.1, IC1.8 (GPB7), OC1.4 (C), R5.1
SNS2: C3.1, IC1.7 (GPB6), OC2.4 (C), R7.1
SNS3: C4.1, IC1.6 (GPB5), OC3.4 (C), R9.1
SNS4: C5.1, IC1.5 (GPB4), OC4.4 (C), R11.1
SNS5: C6.1, IC1.4 (GPB3), OC5.4 (C), R13.1
SNS6: C7.1, IC1.3 (GPB2), OC6.4 (C), R15.1
SNS7: C8.1, IC1.2 (GPB1), OC7.4 (C), R17.1
SNS8: C9.1, IC1.1 (GPB0), OC8.4 (C), R19.1
SW1: J10.2, NODEMCU.23 (D5), S1.4
SW2: J9.2, NODEMCU.22 (D6), S1.3
SYS_LED: NODEMCU.27 (D3), R28.1
VCC: C1.+, J1.2, J2.2, J3.2, J4.2, J5.2, J6.2, J7.2, J8.2, J9.1, J10.1, JDC0.3, JDC1.3, NODEMCU.15 (VIN), RELAY1.COIL1, RELAY2.COIL1, RELAY3.COIL1, RELAY4.COIL1, RELAY5.COIL1, RELAY6.COIL1, RELAY7.COIL1, RELAY8.COIL1, U$1.4 (+VO), ULN2803.10

Notes on the sheet:
NODEMCU
POWER SUPPLY
I2C PULLUPS
LOGIC AND I/O CIRCUIT
CURRENT SENSING
RELAY DRIVER
LED INDICATORS (REMOVE JUMPERS IN PRODUCTION TO SAVE CURRENT)
DEBUG_CONTROL
CONNECTORS
NOTES: 1. Opto SFH628A & PC814 Are pin compatible
I/O CONNECTOERS

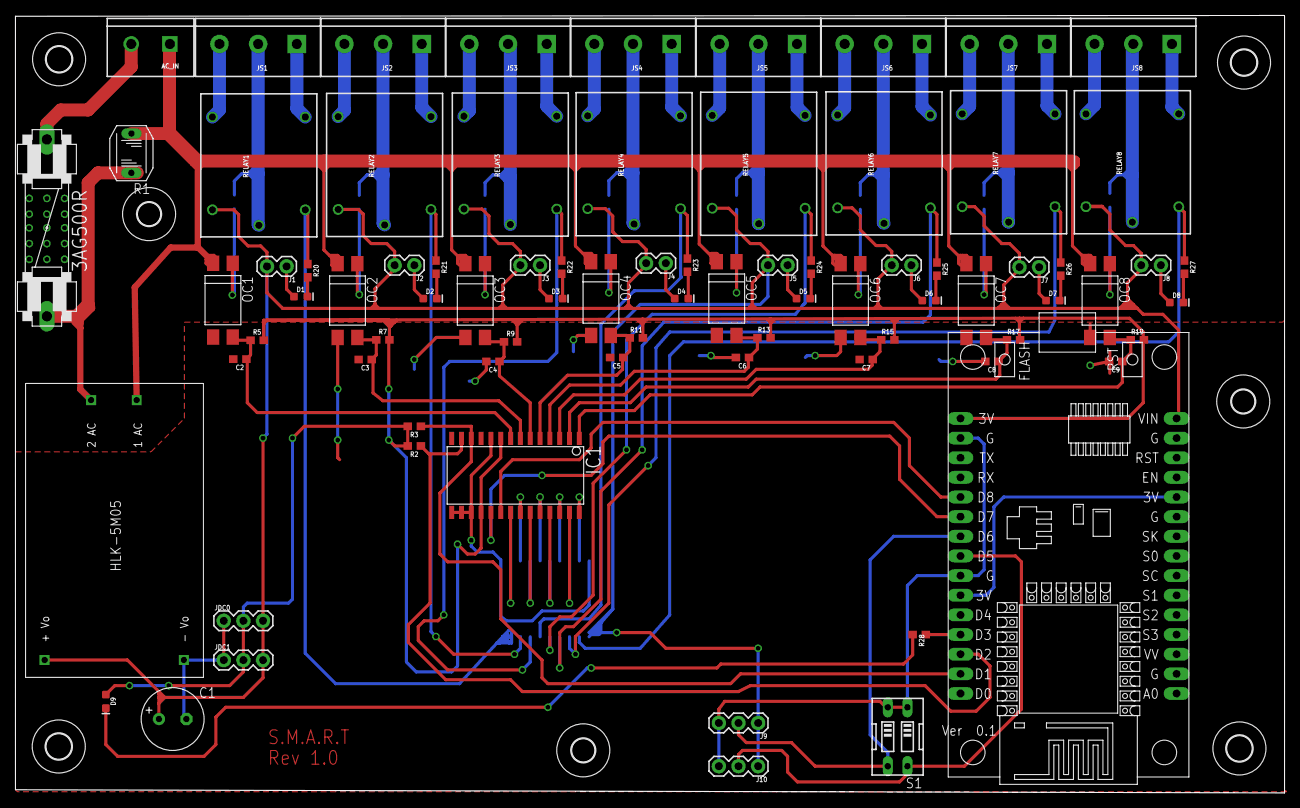
[picture p19: board old_smart_nodemcu_reroute.brd from above]

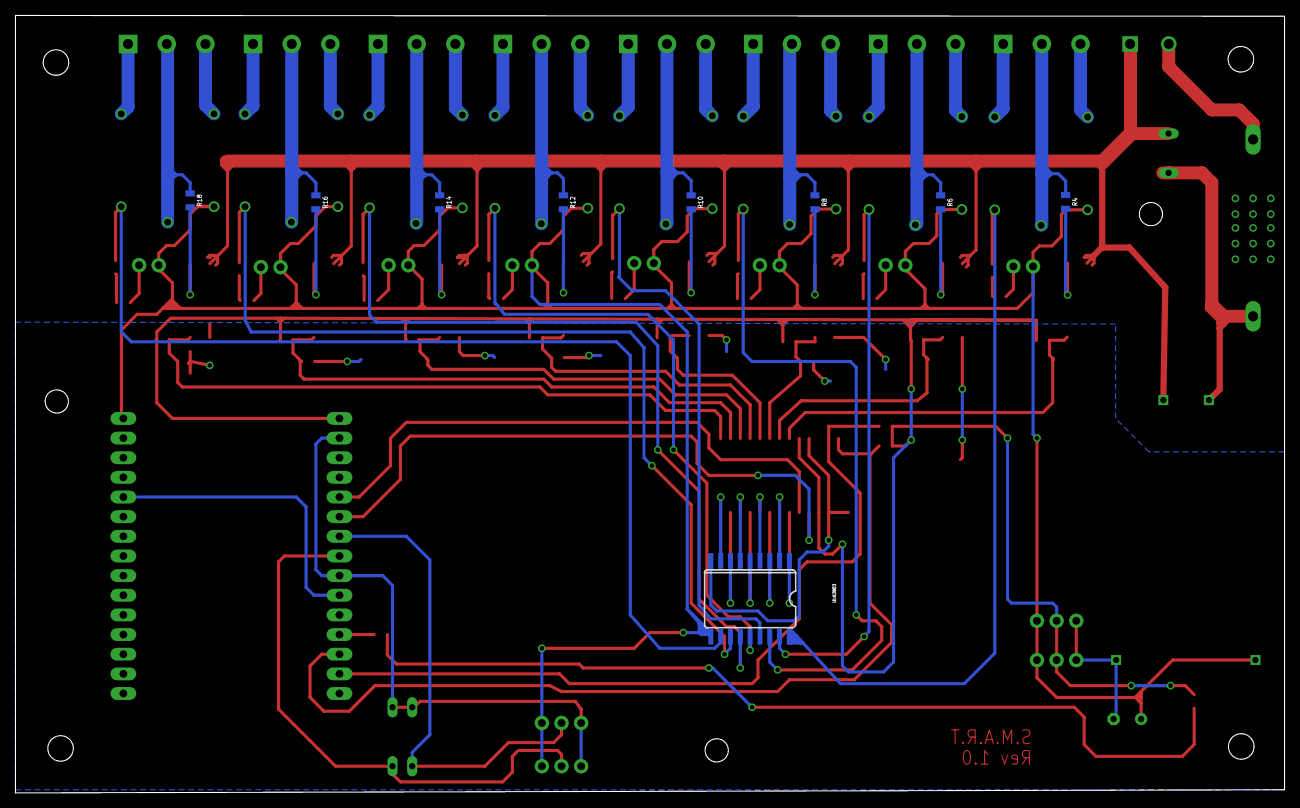
[picture p20: board old_smart_nodemcu_reroute.brd from below]

Board: 2 copper layers, 164.1 x 100.5 mm, 96 parts (9 on the bottom side), 87 nets.
