pranjal-joshi/SMART/LayOutBackup/SMART PiZero Node/PiZero2.brd

## EAGLE design LayOutBackup/SMART PiZero Node/PiZero2.brd (2016-08-30)

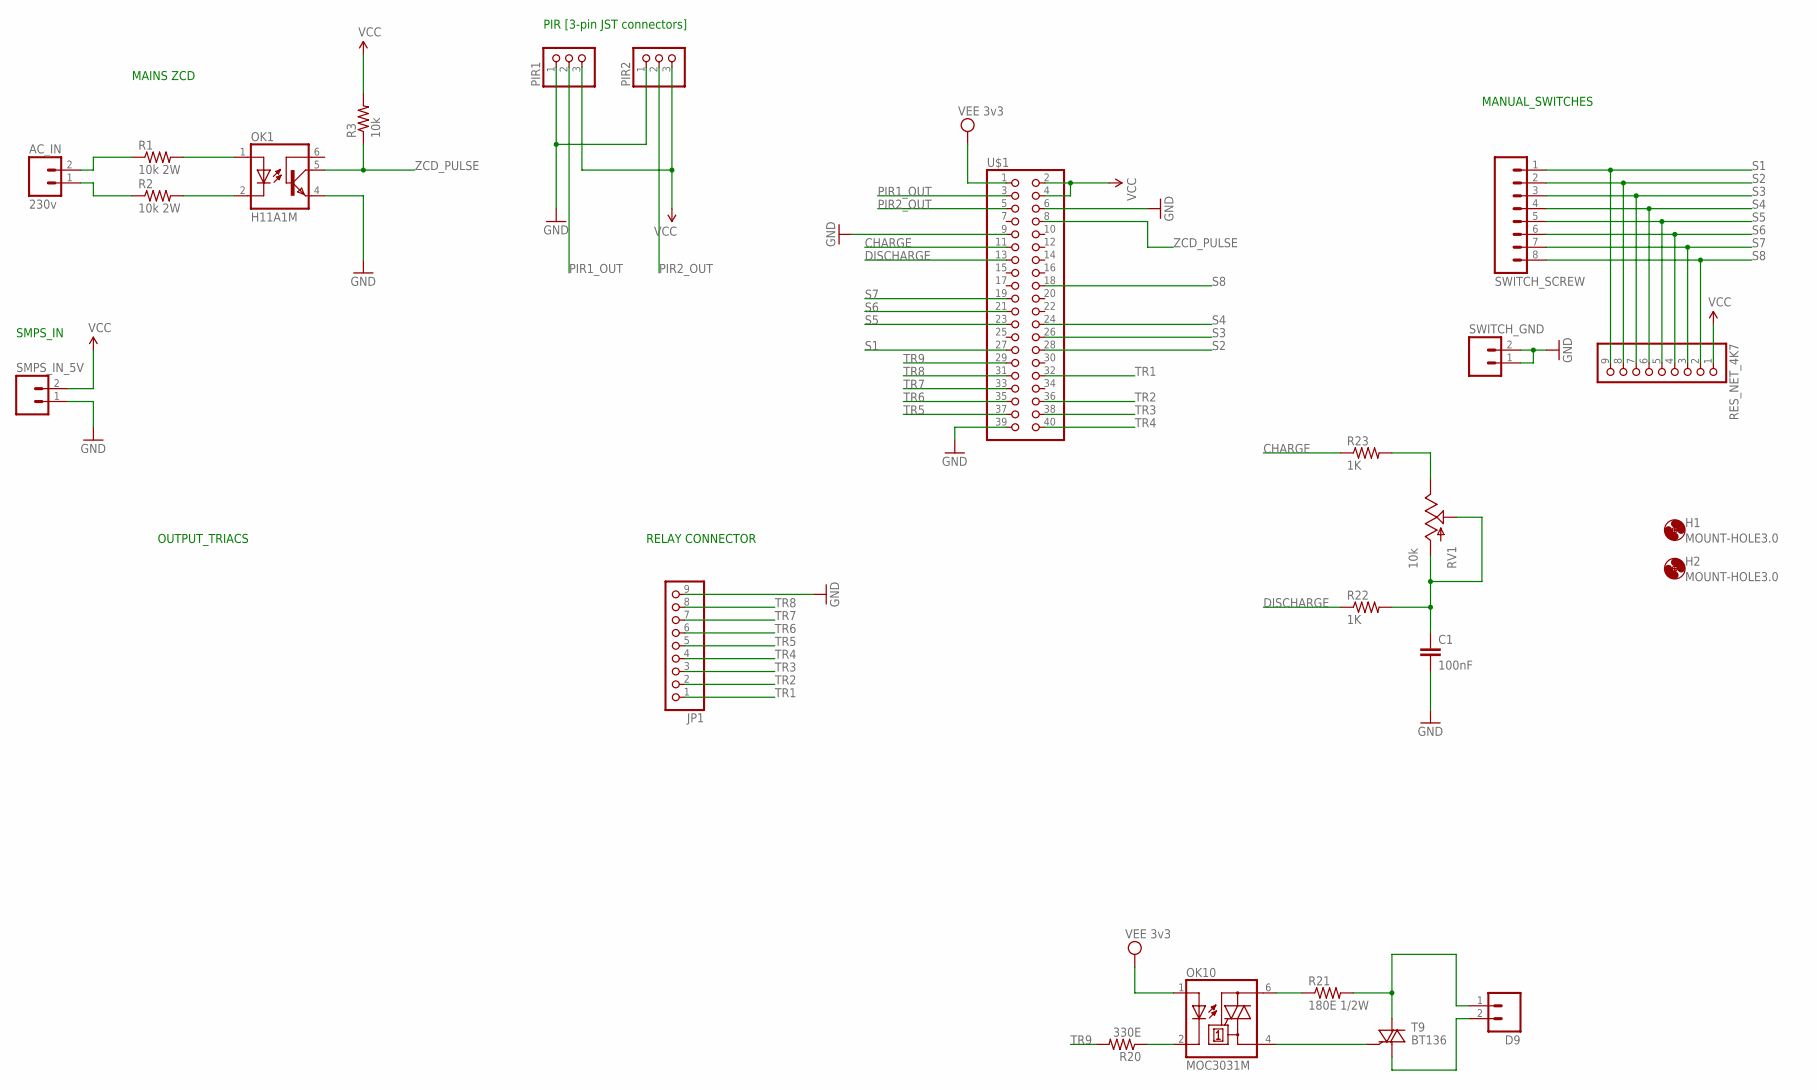
[picture p21: schematic PiZero2.sch]

Parts:
AC_IN: 230v; SCREWTERMINAL-3.5MM-2_LOCK
C1: 100nF; C025-025X050
D9: M023.5MM_LOCK; SCREWTERMINAL-3.5MM-2_LOCK
H1, H2: MOUNT-HOLE3.0; 3,0
JP1: PINHD-1X9/90; 1X09/90
OK1: H11A1M; DIL06
OK10: MOC3031M; DIL06
PIR1, PIR2: PINHD-1X3; 1X03
R1, R2: 10k 2W; AXIAL-0.8
R3: 10k; AXIAL-0.4
R20: 330E; AXIAL-0.4
R21: 180E 1/2W; AXIAL-0.5
R22, R23: 1K; AXIAL-0.4
RES_NET_4K7: PINHD-1X9; 1X09
RV1: 10k; 3362U
SMPS_IN_5V: M023.5MM_LOCK; SCREWTERMINAL-3.5MM-2_LOCK
SWITCH_GND: M023.5MM; SCREWTERMINAL-3.5MM-2
SWITCH_SCREW: M083.5MM-8; SCREWTERMINAL-3.5MM-8
T9: BT136; TO220AB
U$1: PINHD-2X20; 2X20

Connections:
CHARGE: R23.P$1 (1), U$1.11
DISCHARGE: R22.P$1 (1), U$1.13
GND: C1.2, JP1.9, OK1.4 (EMI), PIR1.1, PIR2.1, SMPS_IN_5V.1, SWITCH_GND.1, SWITCH_GND.2, U$1.6, U$1.9, U$1.39
unnamed: AC_IN.2, R1.P$1 (1)
unnamed: AC_IN.1, R2.P$1 (1)
unnamed: OK1.1 (A), R1.P$2 (2)
unnamed: OK1.2 (C), R2.P$2 (2)
unnamed: OK10.6 (A2), R21.P$1 (1)
unnamed: D9.1, R21.P$2 (2), T9.2 (A2)
unnamed: OK10.4 (A1), T9.3 (G)
unnamed: D9.2, T9.1 (A1)
unnamed: OK10.2 (C), R20.P$1 (1)
unnamed: C1.1, R22.P$2 (2), RV1.P$2 (S), RV1.P$3 (A)
unnamed: R23.P$2 (2), RV1.P$1 (E)
PIR1_OUT: PIR1.2, U$1.3
PIR2_OUT: PIR2.2, U$1.5
S1: RES_NET_4K7.9, SWITCH_SCREW.1, U$1.27
S2: RES_NET_4K7.8, SWITCH_SCREW.2, U$1.28
S3: RES_NET_4K7.7, SWITCH_SCREW.3, U$1.26
S4: RES_NET_4K7.6, SWITCH_SCREW.4, U$1.24
S5: RES_NET_4K7.5, SWITCH_SCREW.5, U$1.23
S6: RES_NET_4K7.4, SWITCH_SCREW.6, U$1.21
S7: RES_NET_4K7.3, SWITCH_SCREW.7, U$1.19
S8: RES_NET_4K7.2, SWITCH_SCREW.8, U$1.18
TR1: JP1.1, U$1.32
TR2: JP1.2, U$1.36
TR3: JP1.3, U$1.38
TR4: JP1.4, U$1.40
TR5: JP1.5, U$1.37
TR6: JP1.6, U$1.35
TR7: JP1.7, U$1.33
TR8: JP1.8, U$1.31
TR9: R20.P$2 (2), U$1.29
VCC: PIR1.3, PIR2.3, R3.P$2 (2), RES_NET_4K7.1, SMPS_IN_5V.2, U$1.2, U$1.4
VEE: OK10.1 (A), U$1.1
ZCD_PULSE: OK1.5 (COL), R3.P$1 (1), U$1.8

Notes on the sheet:
MAINS ZCD
SMPS_IN
PIR [3-pin JST connectors]
OUTPUT_TRIACS
MANUAL_SWITCHES
RELAY CONNECTOR

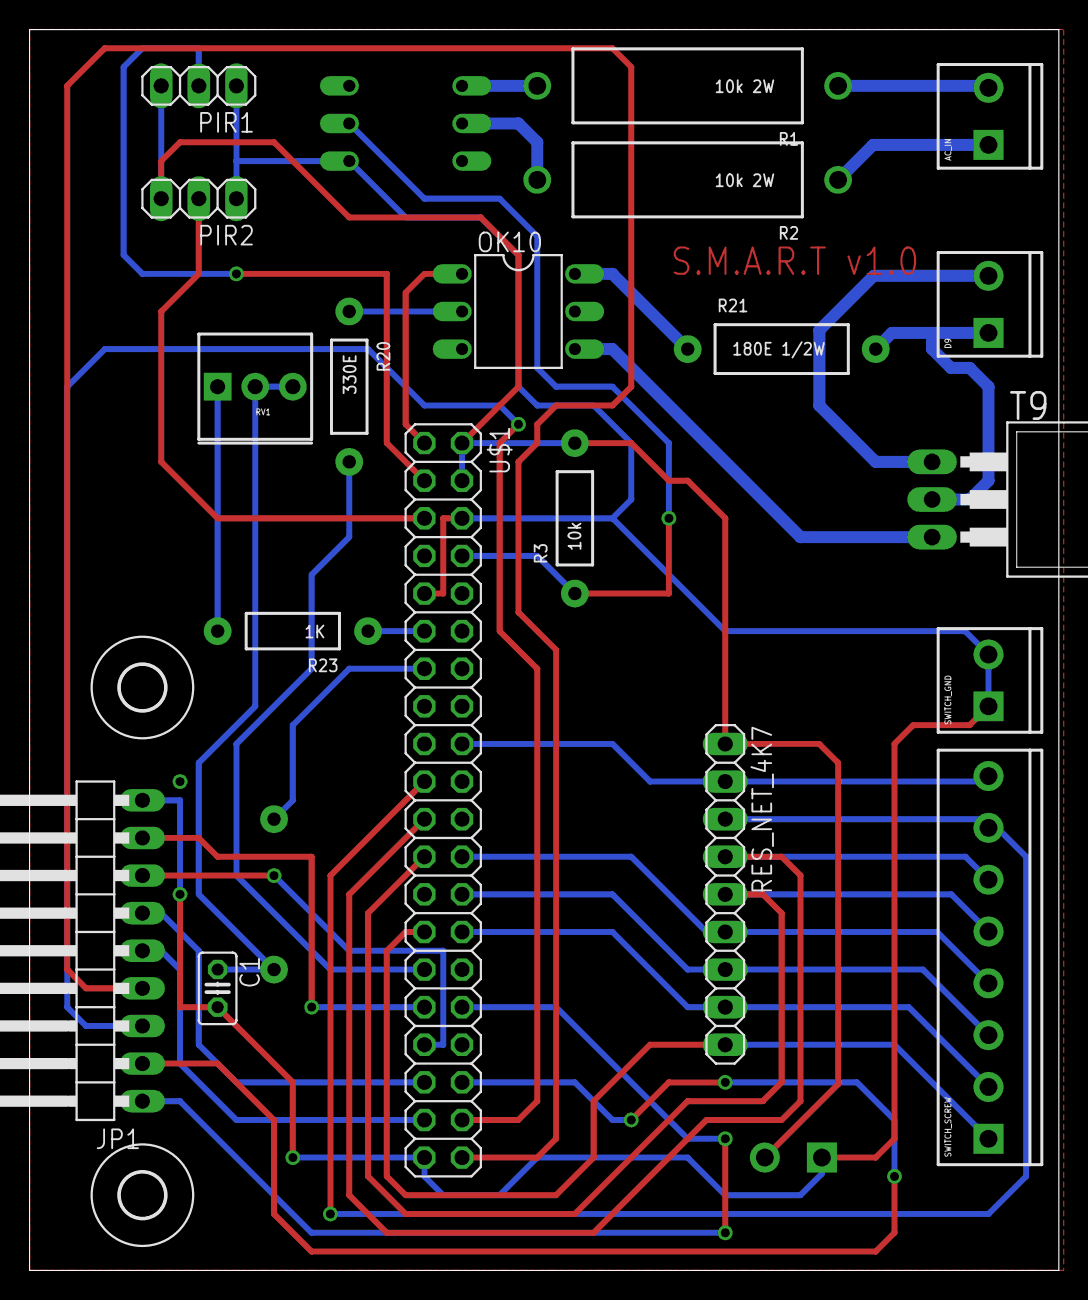
[picture p22: board PiZero2.brd from above]

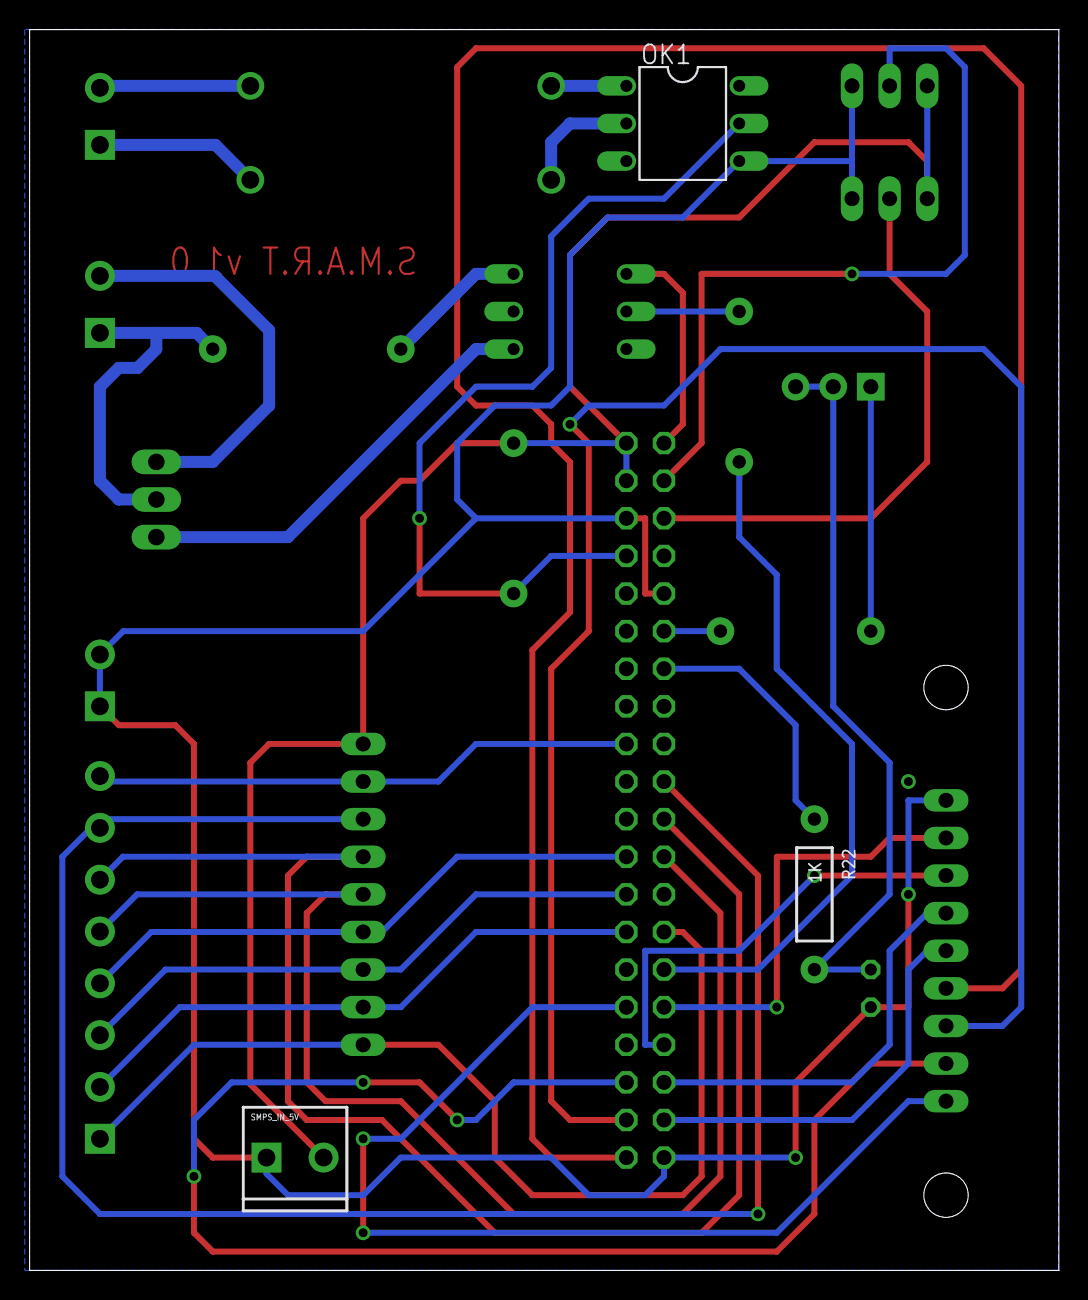
[picture p23: board PiZero2.brd from below]

Board: 2 copper layers, 69.5 x 83.8 mm, 24 parts (3 on the bottom side), 36 nets.
