pranjal-joshi/SMART/LayOutBackup/SMART sensorBox/sensorBox.brd

## EAGLE design LayOutBackup/SMART sensorBox/sensorBox.brd (2016-08-30)

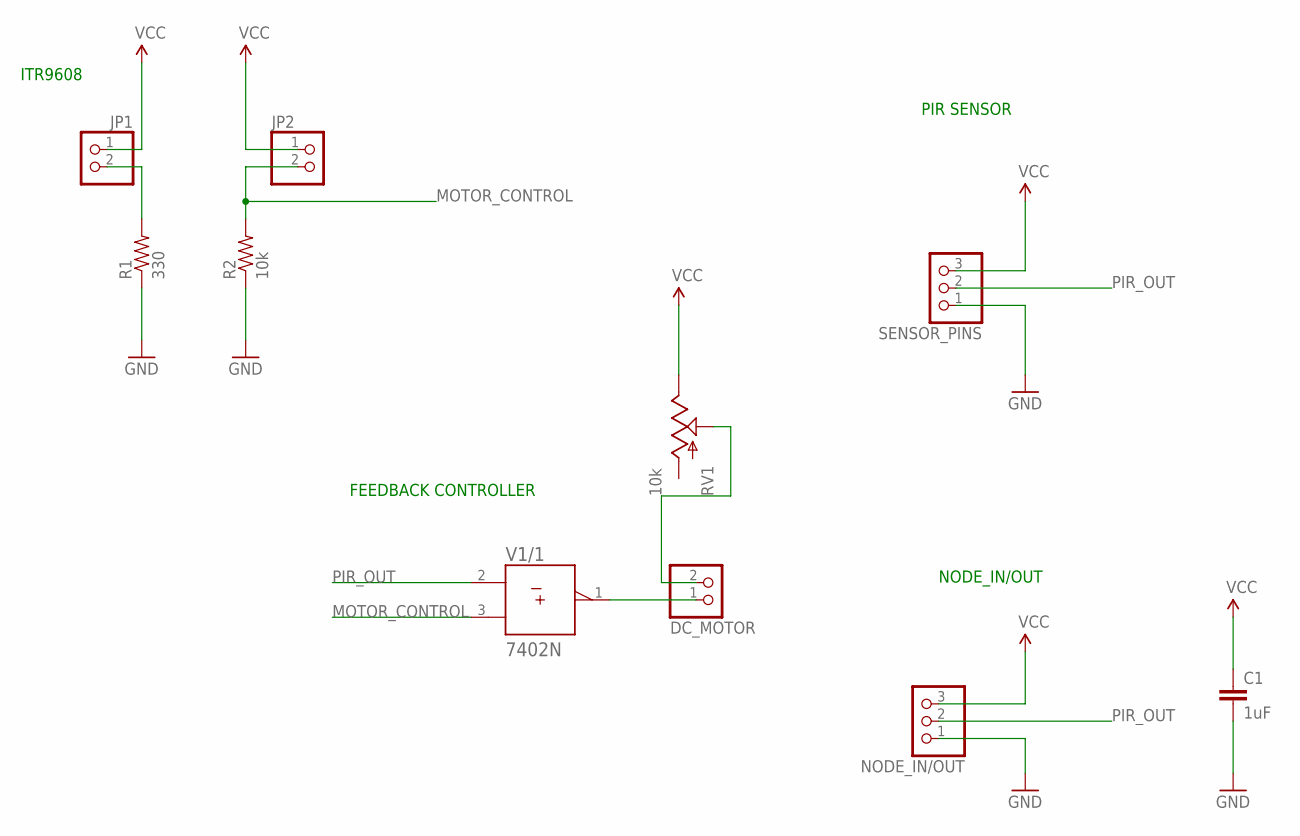
[picture p24: schematic sensorBox.sch]

Parts:
C1: 1uF; CAP-PTH-SMALL
DC_MOTOR: PINHD-1X2; 1X02
JP1, JP2: PINHD-1X2; 1X02
NODE_IN/OUT: PINHD-1X3; 1X03
R1: 330; AXIAL-0.4
R2: 10k; AXIAL-0.4
RV1: 10k; TRIM_POT
SENSOR_PINS: PINHD-1X3; 1X03
V1: 7402N; DIL14

Connections:
+UB: V1.14 (+UB)
-UB: V1.7 (-UB)
GND: C1.2, NODE_IN/OUT.1, R1.P$1 (1), R2.P$1 (1), SENSOR_PINS.1
MOTOR_CONTROL: JP2.2, R2.P$2 (2), V1.3 (B)
unnamed: JP1.2, R1.P$2 (2)
unnamed: DC_MOTOR.2, RV1.1 (S)
unnamed: DC_MOTOR.1, V1.1 (Y)
PIR_OUT: NODE_IN/OUT.2, SENSOR_PINS.2, V1.2 (A)
VCC: C1.1, JP1.1, JP2.1, NODE_IN/OUT.3, RV1.2 (E), SENSOR_PINS.3

Notes on the sheet:
ITR9608
FEEDBACK CONTROLLER
PIR SENSOR
NODE_IN/OUT

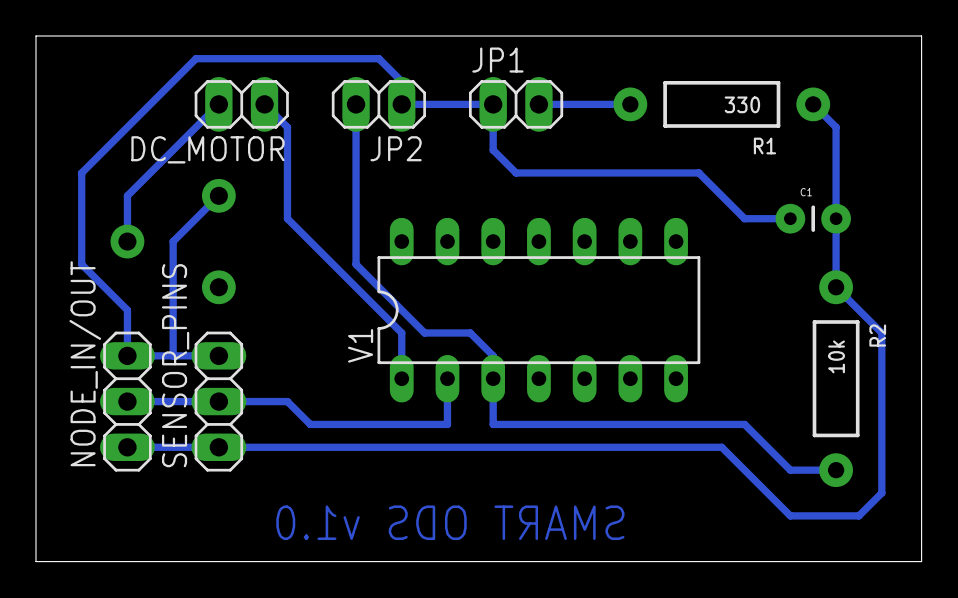
[picture p25: board sensorBox.brd from above]

Board: 2 copper layers, 49.2 x 29.2 mm, 10 parts (1 on the bottom side), 7 nets.
