pranjal-joshi/SMART/LayOutBackup/SMART PiZero Node/piZero_node.brd

## EAGLE design LayOutBackup/SMART PiZero Node/piZero_node.brd (2016-08-30)

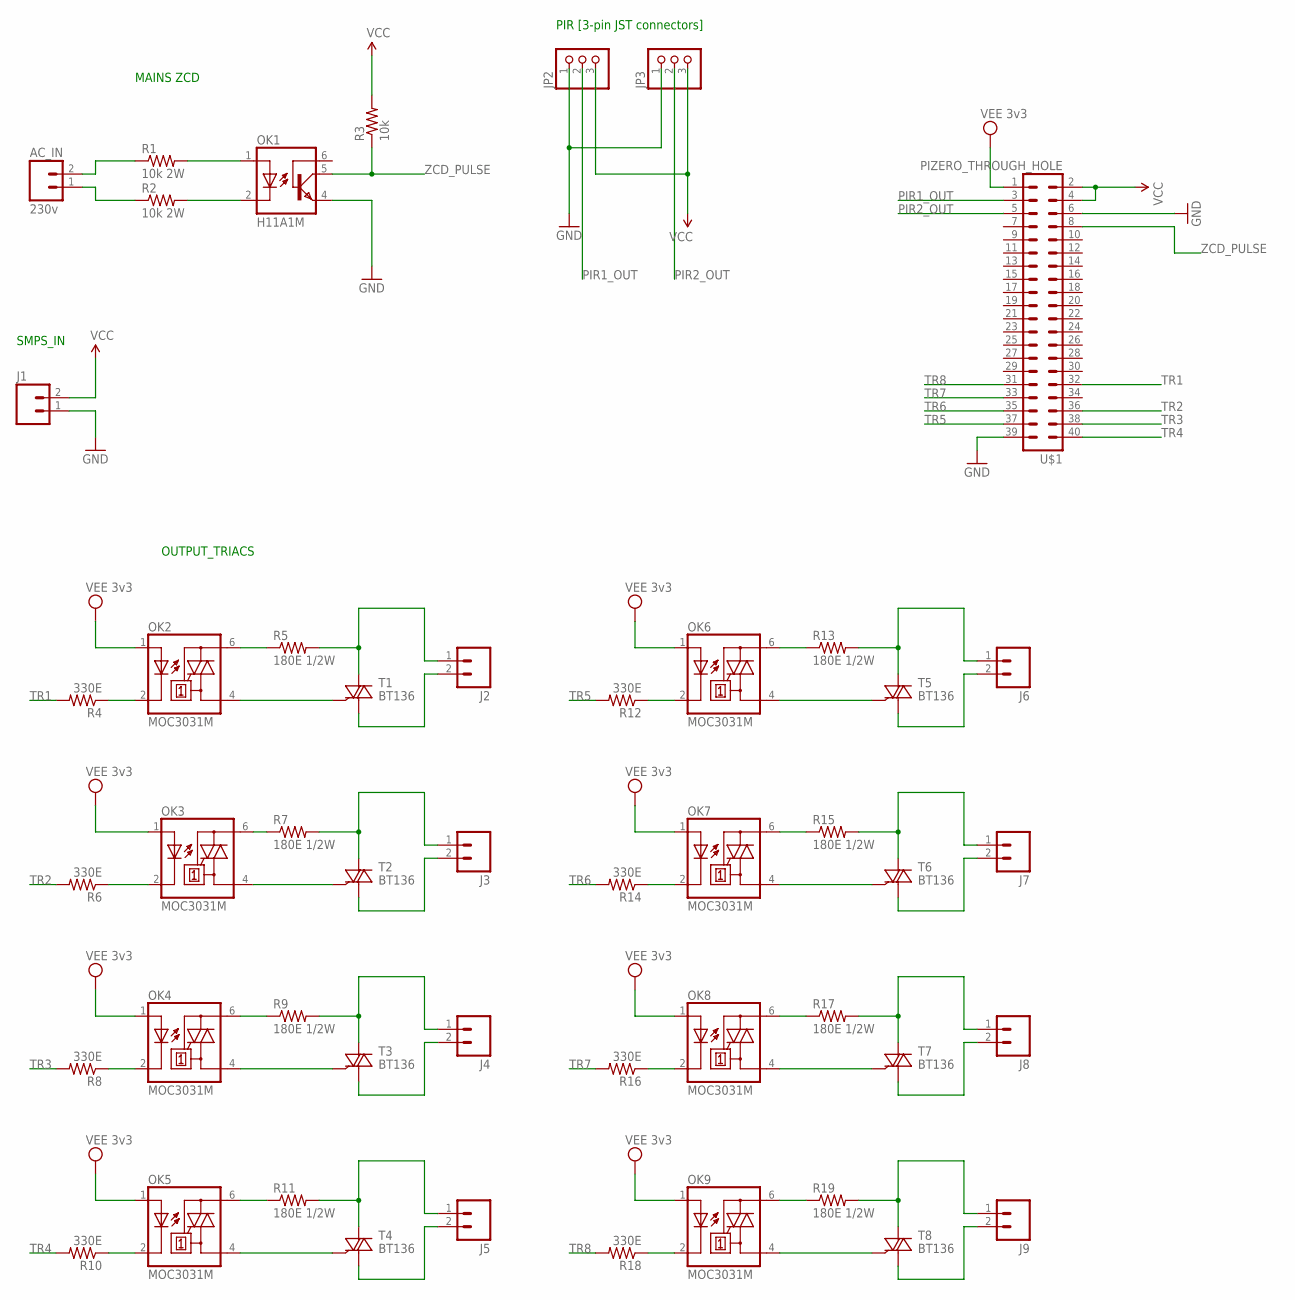
[picture p26: schematic piZero_node.sch]

Parts:
AC_IN: 230v; SCREWTERMINAL-3.5MM-2_LOCK
J1, J2, J3, J4, J5, J6, J7, J8, J9: M023.5MM_LOCK; SCREWTERMINAL-3.5MM-2_LOCK
JP2, JP3: PINHD-1X3; 1X03
OK1: H11A1M; DIL06
OK2, OK3, OK4, OK5, OK6, OK7, OK8, OK9: MOC3031M; DIL06
R1, R2: 10k 2W; AXIAL-0.8
R3: 10k; AXIAL-0.4
R4, R6, R8, R10, R12, R14, R16, R18: 330E; AXIAL-0.4
R5, R7, R9, R11, R13, R15, R17, R19: 180E 1/2W; AXIAL-0.5
T1, T2, T3, T4, T5, T6, T7, T8: BT136; TO220AB
U$1: PIZERO_THROUGH_HOLE; PIZERO_THOUGH_HOLE

Connections:
GND: J1.1, JP2.1, JP3.1, OK1.4 (EMI), U$1.6, U$1.39
unnamed: AC_IN.2, R1.P$1 (1)
unnamed: AC_IN.1, R2.P$1 (1)
unnamed: OK1.1 (A), R1.P$2 (2)
unnamed: OK1.2 (C), R2.P$2 (2)
unnamed: OK3.6 (A2), R7.P$1 (1)
unnamed: OK2.6 (A2), R5.P$1 (1)
unnamed: J2.1, R5.P$2 (2), T1.2 (A2)
unnamed: OK2.4 (A1), T1.3 (G)
unnamed: J2.2, T1.1 (A1)
unnamed: OK2.2 (C), R4.P$1 (1)
unnamed: J3.1, R7.P$2 (2), T2.2 (A2)
unnamed: OK3.4 (A1), T2.3 (G)
unnamed: J3.2, T2.1 (A1)
unnamed: OK3.2 (C), R6.P$1 (1)
unnamed: OK4.6 (A2), R9.P$1 (1)
unnamed: J4.1, R9.P$2 (2), T3.2 (A2)
unnamed: OK4.4 (A1), T3.3 (G)
unnamed: J4.2, T3.1 (A1)
unnamed: OK4.2 (C), R8.P$1 (1)
unnamed: OK5.6 (A2), R11.P$1 (1)
unnamed: J5.1, R11.P$2 (2), T4.2 (A2)
unnamed: OK5.4 (A1), T4.3 (G)
unnamed: J5.2, T4.1 (A1)
unnamed: OK5.2 (C), R10.P$1 (1)
unnamed: OK6.6 (A2), R13.P$1 (1)
unnamed: J6.1, R13.P$2 (2), T5.2 (A2)
unnamed: OK6.4 (A1), T5.3 (G)
unnamed: J6.2, T5.1 (A1)
unnamed: OK6.2 (C), R12.P$1 (1)
unnamed: OK7.6 (A2), R15.P$1 (1)
unnamed: J7.1, R15.P$2 (2), T6.2 (A2)
unnamed: OK7.4 (A1), T6.3 (G)
unnamed: J7.2, T6.1 (A1)
unnamed: OK7.2 (C), R14.P$1 (1)
unnamed: OK8.6 (A2), R17.P$1 (1)
unnamed: J8.1, R17.P$2 (2), T7.2 (A2)
unnamed: OK8.4 (A1), T7.3 (G)
unnamed: J8.2, T7.1 (A1)
unnamed: OK8.2 (C), R16.P$1 (1)
unnamed: OK9.6 (A2), R19.P$1 (1)
unnamed: J9.1, R19.P$2 (2), T8.2 (A2)
unnamed: OK9.4 (A1), T8.3 (G)
unnamed: J9.2, T8.1 (A1)
unnamed: OK9.2 (C), R18.P$1 (1)
PIR1_OUT: JP2.2, U$1.3
PIR2_OUT: JP3.2, U$1.5
TR1: R4.P$2 (2), U$1.32
TR2: R6.P$2 (2), U$1.36
TR3: R8.P$2 (2), U$1.38
TR4: R10.P$2 (2), U$1.40
TR5: R12.P$2 (2), U$1.37
TR6: R14.P$2 (2), U$1.35
TR7: R16.P$2 (2), U$1.33
TR8: R18.P$2 (2), U$1.31
VCC: J1.2, JP2.3, JP3.3, R3.P$2 (2), U$1.2, U$1.4
VEE: OK2.1 (A), OK3.1 (A), OK4.1 (A), OK5.1 (A), OK6.1 (A), OK7.1 (A), OK8.1 (A), OK9.1 (A), U$1.1
ZCD_PULSE: OK1.5 (COL), R3.P$1 (1), U$1.8

Notes on the sheet:
MAINS ZCD
SMPS_IN
PIR [3-pin JST connectors]
OUTPUT_TRIACS

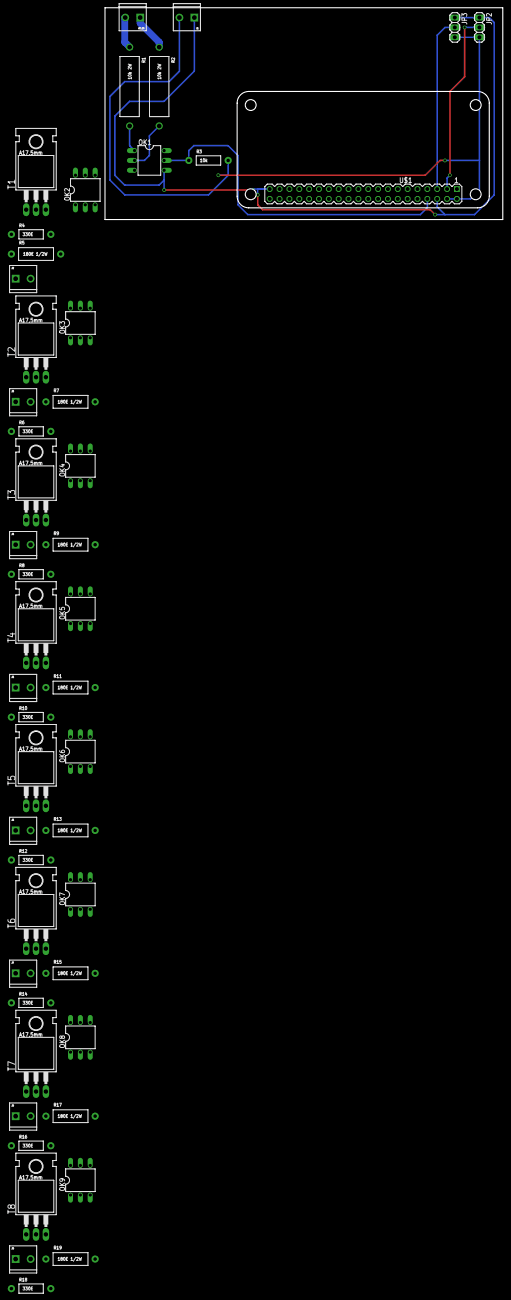
[picture p27: board piZero_node.brd from above]

Board: 2 copper layers, 102.5 x 54.6 mm, 49 parts (0 on the bottom side), 58 nets.
