pranjal-joshi/SMART/v3/ESP/smart_v3/SmartWebServer.h

/*
 * SMART Node - v3.0
 * AUTHOR   :   PRANJAL JOSHI
 * DATE     :   31/05/2020
 * INFO     :   Header for AP web server to acquire config
 * ALL RIGHTS RESERVED.
 */

#ifndef SMARTWEBSERVER_H
#define SMARTWEBSERVER_H

#define WEBSERVER_H         // This avoids Redeclaration Error in ESPAsyncWebServer.h

#include <ESP8266mDNS.h>
#include <ESP8266HTTPUpdateServer.h>
#include <ESP8266WiFi.h>
#include <ESPAsyncTCP.h>
#include <ESPAsyncWebServer.h>

class SmartWebServer {
  public:
    SmartWebServer(void);
    void setDebug(bool);
    void begin(const char* ssid, const char* pass);
    void showWifiNetworks(void);
    void beginOta(void);
    void loop(void);
  private:
};

#endif
