pranjal-joshi/SMART/v4_alexa_based/alexa_routine_trigger/Webpages.h

#ifndef WEBPAGES_H
#define WEBPAGES_H

#include <avr/pgmspace.h>

extern const char config_saved_html[] PROGMEM;
extern const char config_reset_html[] PROGMEM;
extern const char index_html[] PROGMEM;

#endif
