pranjal-joshi/SMART/SMART_TESTING_CODES/RF24Network_tx/RF24Network_tx.ino

/*
 Copyright (C) 2012 James Coliz, Jr. <maniacbug@ymail.com>

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
 Update 2014 - TMRh20
 */

/**
 * Simplest possible example of using RF24Network 
 *
 * TRANSMITTER NODE
 * Every 2 seconds, send a payload to the receiver node.
 */

#include <RF24Network.h>
#include <RF24.h>
#include <SPI.h>

RF24 radio(9,10);                    // nRF24L01(+) radio attached using Getting Started board 

RF24Network network(radio);          // Network uses that radio

const uint16_t this_node = 011;        // Address of our node
const uint16_t other_node = 00;       // Address of the other node
const uint16_t router = 01;

const unsigned long interval = 1000; //ms  // How often to send 'hello world to the other unit

unsigned long last_sent;             // When did we last send?
unsigned long packets_sent;          // How many have we sent already


struct payload_t {                  // Structure of our payload
  byte addr;
  byte device;
  byte val;
  byte repeate;
  byte ack;
};

void setup(void)
{
  Serial.begin(9600);
  Serial.println("RF24Network/examples/helloworld_tx/");
 
  SPI.begin();
  radio.begin();
  network.begin(/*channel*/ 90, /*node address*/ this_node);
  radio.setPALevel(RF24_PA_MAX);
  radio.setDataRate(RF24_250KBPS);
}

payload_t backupPayload;

void loop() {
  
  network.update();                          // Check the network regularly

  
  unsigned long now = millis();              // If it's time to send a message, send it!
  if ( now - last_sent >= interval  )
  {
    last_sent = now;

    Serial.print("Sending...");
    payload_t payload = { this_node, 3, 1, 0, 0 };
    RF24NetworkHeader header(/*to node*/ other_node);
    bool ok = network.write(header,&payload,sizeof(payload));
    if (ok)
      Serial.println("ok.");
    else
      Serial.println("failed.");
  }
  
  while(network.available())
  {
    RF24NetworkHeader h;
    payload_t ackCheck = {this_node, 0, 0, 0, 0};
    network.read(h,&ackCheck,sizeof(ackCheck));
    if(ackCheck.ack == 1)
      Serial.print("Got ACK.");
    else
      Serial.print("Got NAK.");
    Serial.print(" From addr: ");
    Serial.println(h.from_node);
  }
}
