pranjal-joshi/SMART/(commit log)

2015-04-20 added code to program i2c eeprom.
2015-05-30 python file for raspberry pi added.
2015-06-01 real time response from database to smart app added
    when user selects any room from the app, the present status of
    particular room is fetched from database and sent to app to indicate
    on/off buttons.
2015-06-05 read register & system logging added.
    readRegister will be triggered at every 5ms. uses thread. sysLog will
    log given string with time stamp in sys.log file.
2015-06-10 room nodes will now use 8051 mcus instead of AVRs.
    Tasks:
    1. read PIRs to detect entry/exit.
    2. read 8 push button switches.
    3. transmit data to SMART_CPU over RF.
2015-11-06 fan parseInt added.
2016-08-17 switch interrupt, RC ADC check thread added
2016-08-23 appActivity thread added.
2016-08-30 Hardware design backup.
    [PiZero2.brd, PiZero2.sch, piZero_node.brd, piZero_node.sch, piZero_node_new.brd, piZero_node_new.sch, sensorBox.brd, sensorBox.sch]
2016-09-04 Web app welcome page added. Materialize
2016-09-04 schedule button with modal & time picker added.
2016-09-06 settings button with dropdown and icons in control added.
2016-09-11 material title icons added.
2016-09-13 javascript added to load room names, device names & switch values.
2016-10-12 Help page added. Smart icon added. fan animation added to control.
2016-10-28 ZCD interrupt and timestamp implemented.
2016-10-28 Timer service added.
2016-10-29 Timer working javascript added. HTML improvements.
2016-11-01 motion sensor trigger & handler added.
2016-11-02 Major bug fixes.
    1. MySQL threads - multiple connection created for multithreaded cursor.
    2. timerService bug is still there.. =....=
    [node_server.py, smart.py]
2016-11-07 few logical bug fixes and new json formats.
    [smartSocket.py]
2016-11-08 Socket compatibility added.
2016-11-11 Sockets working & performance improvements
2016-12-22 Timer update on page load & profiles. Tested & working.
2016-12-22 Profile & Timer. UI fully working.
2016-12-22 timer None:None bug fixed
2016-12-23 socket onOpen now triggers onload. Timeout method can be eliminated.
2017-01-02 Timer modal GUI updated
2017-01-13 Fan knob added. Working & tested.
2019-02-07 todo: solve json writing error
    [SMART_2.ino.ino]
2019-02-09 blynk cloud connection fixed
    [SMART_2.ino.ino]
2019-02-10 token saving bug fixed
    [SMART_2.ino.ino]
2020-06-01 Broken - to be fixed painlessMesh object
    [smart_v3.ino]
2020-06-01 todo - debug readJsonFile pointer issue
    [smart_v3.ino]
2020-06-02 readConfigFile bug fixed by StaticJsonDoc
    [smartFileSystem.cpp, smartFileSystem.h]
2020-06-03 Crash bug fixed in AsyncWebReq
    Don't use delay or SPIFFS read that yeilds inside an async callback
    [SmartWebServer.cpp]
2020-06-05 getSmartSSID & isInternetAvail fixed
    [smart_v3.ino]
2020-06-06 BOM created
2020-06-06 searchTargetSSID task added if target is not found since boot
    Debug mesh.init() as it doesn't behave properly after mesh.end()
    [smart_v3.ino]
2020-06-07 BOM modified
    [BOM.xlsx]
2020-06-07 v3 board in progress
    [old_smart_nodemcu_reroute.brd, old_smart_nodemcu_reroute.sch, v3.brd, v3.sch]
2020-06-08 v3 PCB routing completed
    [v3.brd, v3.sch]
2020-06-09 OE pulled up
    [copper_bottom.gbr, copper_top.gbr, drill_1_16.xln, gerber_job.gbrjob, profile.gbr, silkscreen_bottom.gbr, silkscreen_top.gbr, soldermask_bottom.gbr]
2020-06-09 OE connected to D0 pin
    [v3.brd, v3.sch]
2020-06-10 PCB OE updated
    [copper_bottom.gbr, copper_top.gbr, drill_1_16.xln, gerber_job.gbrjob, silkscreen_bottom.gbr, silkscreen_top.gbr, soldermask_bottom.gbr, soldermask_top.gbr]
2020-06-10 _isr added
    check for SmartIo.isInterrupted in loop to identify interrupt and disable variable manually
2020-06-10 TODO - fix bugs
    [SmartIO.cpp, SmartIO.h]
2020-06-11 TODO - fix redeclaration
    [SmartIO.cpp, SmartIO.h]
2020-06-14 Final BOM added
    [BOM_Final.xlsx]
2020-06-14 Design files modified
    [v3.csv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]
2020-06-14 getState bug fixed and optimized
    [SmartIO.cpp, SmartIO.h]
2020-06-17 TODO - Impliment timer packet
2020-06-18 timerStructure updated
2020-06-18 save and load timer implemented
2020-06-19 todo - fix mesh not connecting bug
    [smart_v3.ino]
2020-06-20 Major bugfix - Mesh disconnect on ntp.begin()
    [smart_v3.ino]
2020-06-21 todo - fix target ssid not found bug
    [HelperFunctions.ino]
2020-06-21 timerSchedularHandler implemented
2020-06-21 timerSchedHandlerTask added
2020-06-22 timerStruct now have ignore time of 60 sec
2020-06-22 loadTimers PANIC resolved, not using fsys.loadTimers now
    [smart_v3.ino]
2020-06-23 preprocessors added for SWITCHING & SENSOR
2020-06-23 constants replaced with #define
    [HelperFunctions.ino]
2020-06-23 SensorLink JSON parser added
2020-06-23 Sensor Functions added
2020-06-24 get set by sensor methods added
2020-06-24 todo - debug and implement sensor broadcast parsing
2020-06-25 get set by Timer added
2020-06-25 New methods added and bugfixes
    [smartFileSystem.cpp, smartFileSystem.h]
2020-06-25 Sensor broadcast parser implemented
2020-06-25 todo - implement mesh sensor to MQTT routing
2020-06-26 mesh json print on connection callback
2020-06-26 Fingerprints added
2020-06-30 topic added to sensor_broadcast
2020-06-30 sensor_broadcast publish routing added
2020-06-30 OTA packet panic core fixed
    [HelperFunctions.ino, smart_v3.ino]
2020-07-03 SENSOR PIN - FUNCTION_3
2020-07-03 Pin switching between Serial & GPIO for ESP-01
2020-07-03 Will message bug fixed
    [HelperFunctions.ino]
2020-07-05 stateVar inverted for ACTIVE LOW in NoD < 4
    [SmartIO.cpp]
2020-07-05 Sensor improvements
2020-07-05 ToDo: Sensor GPIO selection & testing
2020-07-06 PIN config changed for Sensor
2020-07-06 Replaced ElegantOTA with ESP8266HTTPUpdater
    #define WEBSERVER_H removes redeclaration error
    [SmartWebServer.cpp, SmartWebServer.h]
2020-07-12 NoD 2 Pin config changed
2020-07-12 NOD 2 PCB routing completed
    [v3_NoD_2.brd, v3_NoD_2.sch]
2020-07-22 SwitchboardTile and Class added
2020-07-24 MQTT handlers and switch logic added
2020-07-26 WIP - Switch auto toggle as per State Progress
2020-07-26 Fetching added - room name, NoD, smartId - Dynamic SwitchboardRow implemented
2020-07-27 UI error fixes + MQTT SwitchRow WIP
2020-07-28 WIP - publish SwitchboardRow list
2020-07-28 WIP - Add new device
2020-07-29 Add New Device - completed
2020-08-02 Configure New Device - Almost done!
2020-08-15 PowerIndicator implemented for RoomCards in gridview
2020-08-24 DeviceCard UI Implemented
2020-08-25 Label Provider added for managing device names
2020-08-26 publish states to gateway on switch toggle added
2020-08-28 Device Page Created
2020-08-28 Device Page routes implemented
2020-09-05 save button UI rounded corners removed
2024-05-03 TImeout reduced, led blink added
2024-05-12 GUI updated to mordern, HttpUpdater & WebServer enhanced - WIP factory reset and Re-scan
    [ConfigLoader.h, ConfigLoader.ino, ConfigureWebServer.h, ConfigureWebServer.ino, alexa_routine_trigger.ino, creds.h]
2024-05-13 Working prototype
2024-05-13 Flux PCB files added
2024-05-14 Arduino folder structure updated
2024-05-14 Alexa listener added with devices
2024-05-15 off_timeout bugfixed, sensor state WIP for alexa control
    [ConfigLoader.h, ConfigLoader.ino, ConfigureWebServer.ino, alexa_routine_trigger.ino]
2024-05-15 off_timeout bugfixed, WIP sensor state for alexa & web based control
2024-05-15 Toggle switch added in UI and Alexa braodcast stateChange to control motion sensor
2024-05-16 String comparision bugfix in GET /state
    [ConfigureWebServer.ino]
2024-05-18 OneButton based button added for reset, enable & disable
    [ConfigureWebServer.h, ConfigureWebServer.ino, alexa_routine_trigger.ino, button.ino, creds.h]
2024-05-18 Bugfix for no networks shown in AP mode
    [ConfigureWebServer.ino]
2024-05-20 Removed WiFi multi to eliminate blocking delays in loop that affects AP serving and other LED/button operations
2024-05-20 Bugfixes and Perf upgrades
    [ConfigureWebServer.ino, alexa_routine_trigger.ino]
2024-05-20 button & led setup moved at begining, WiFi wait added before starting server
2024-05-27 LED & preprocessor changed
2024-05-28 WIP - Pin update for ESP01-S
2024-05-30 led working for ESP01/S & NodeMCU
2024-05-30 PCB layout added
2024-06-01 NODEMCU Led changed to GPIO16
2024-06-03 timer_ignore_sensoe added to reduce false positives
2025-06-06 Blueprint for updating scene when device state changes manually
