pranjal-joshi/SMART/(notices)

Notices in the files:
SMART_TESTING_CODES/RF24Network_tx/RF24Network_tx.ino:
modify it under the terms of the GNU General Public License
parts and their libraries:
SparkFun-Connectors: Licensing: Creative Commons ShareAlike 4.0 International - https://creativecommons.org/licenses/by-sa/4.0
ESP-01: Released under the Creative Commons Attribution 4.0 International License: http://creativecommons.org/licenses/by/4.0
